GarryBGoode/VibeSupply/out/placement_control.png

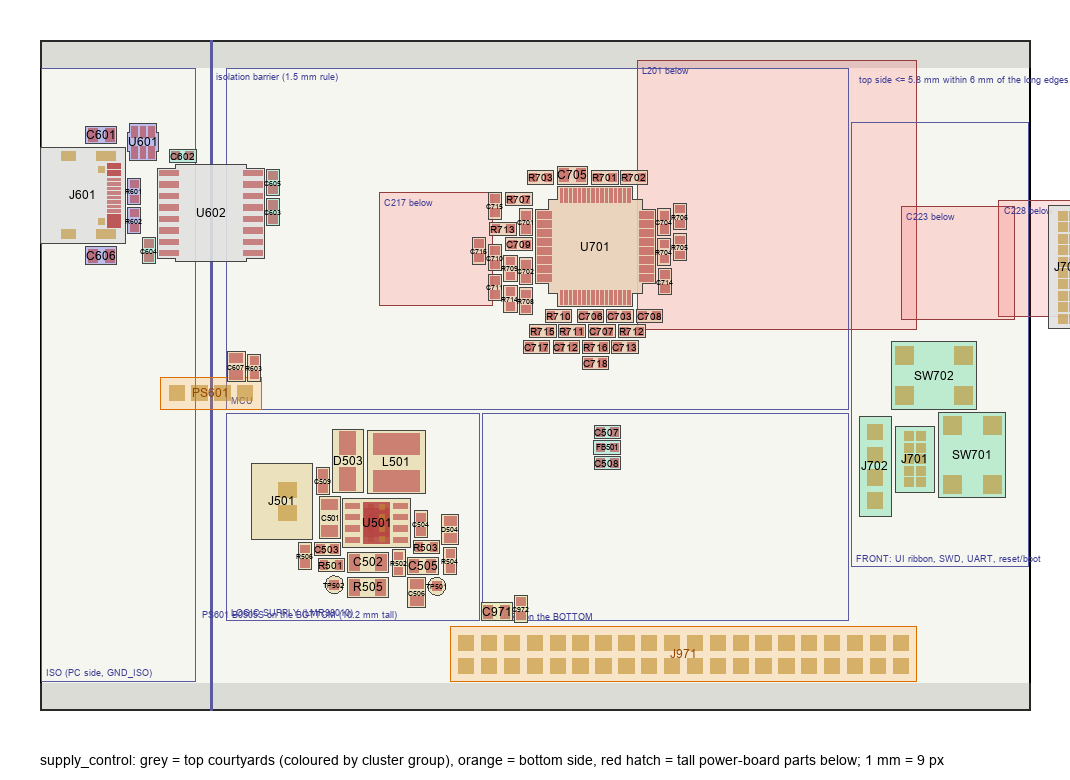
out/placement_control.png
