GarryBGoode/VibeSupply/out/placement_power.png

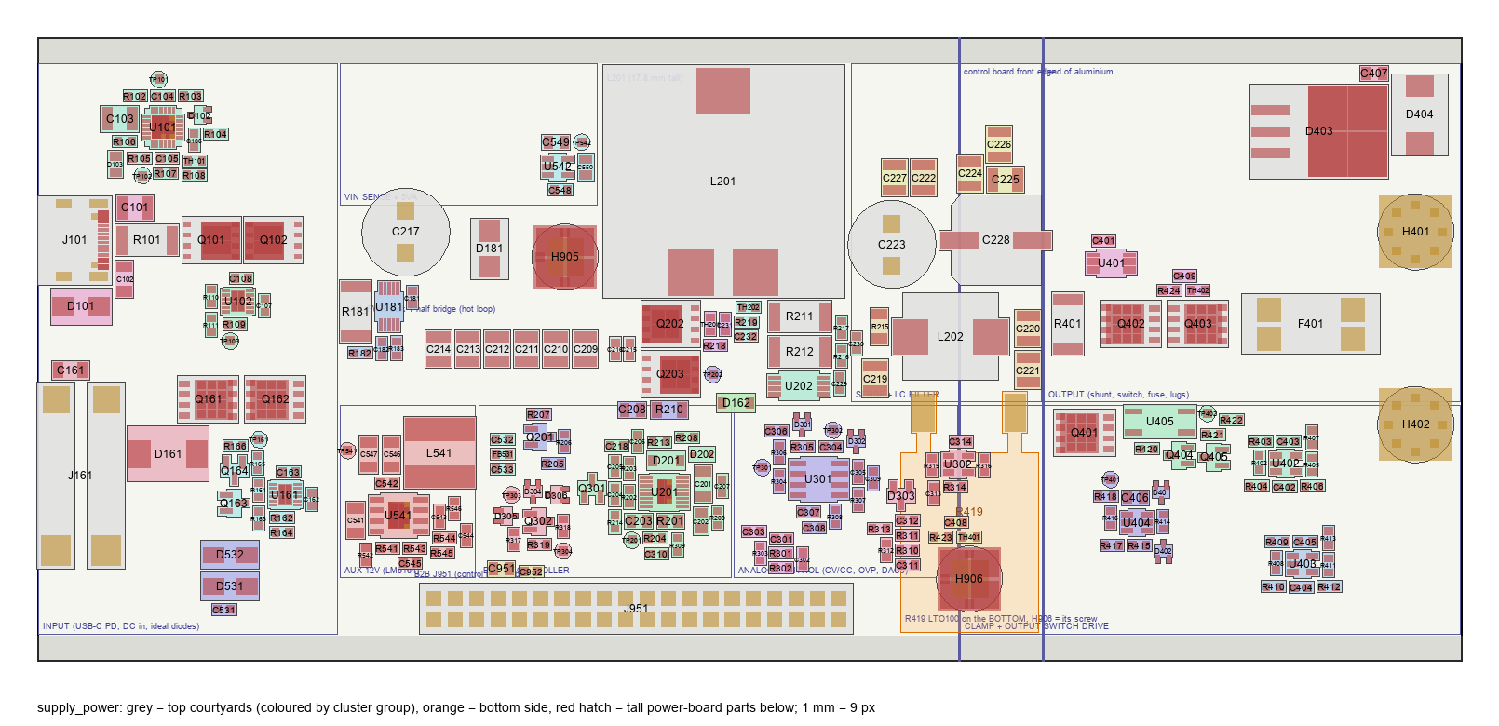
out/placement_power.png
