GarryBGoode/VibeSupply/out/placement_ui.png

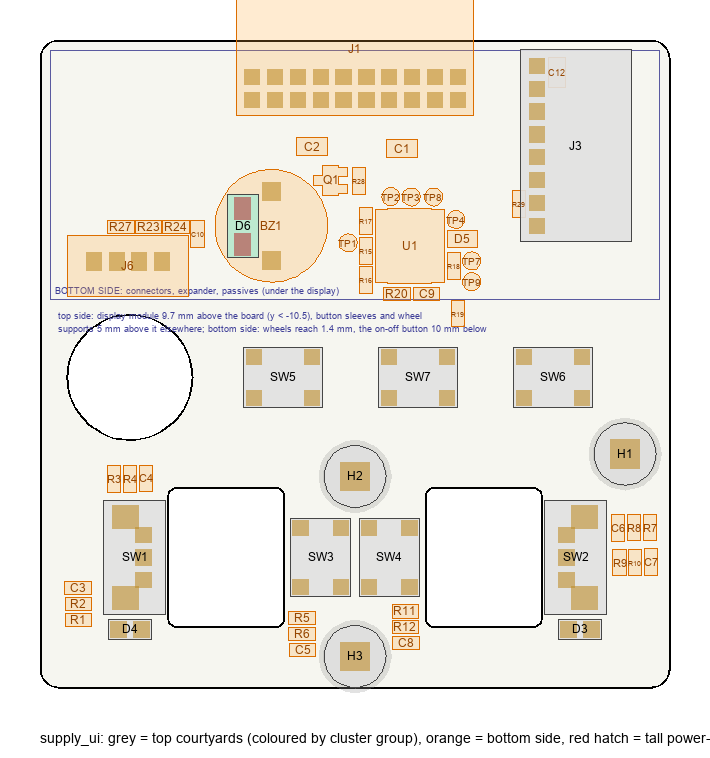
out/placement_ui.png
