GarryBGoode/VibeSupply/sim/plots/t0_ith_probe.png

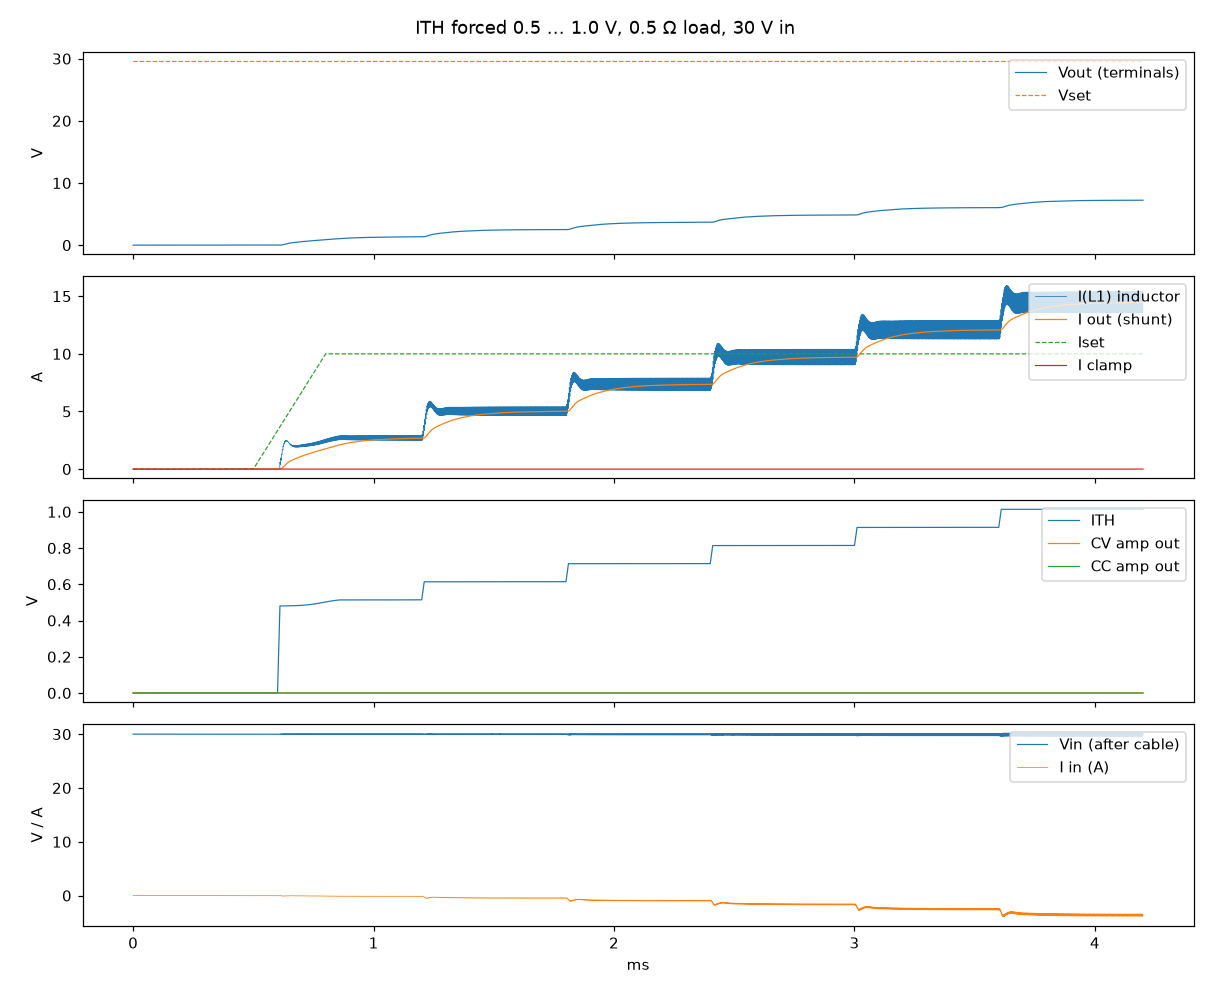
sim/plots/t0_ith_probe.png
