GarryBGoode/VibeSupply/sim/plots/t2_cv_pwm.png

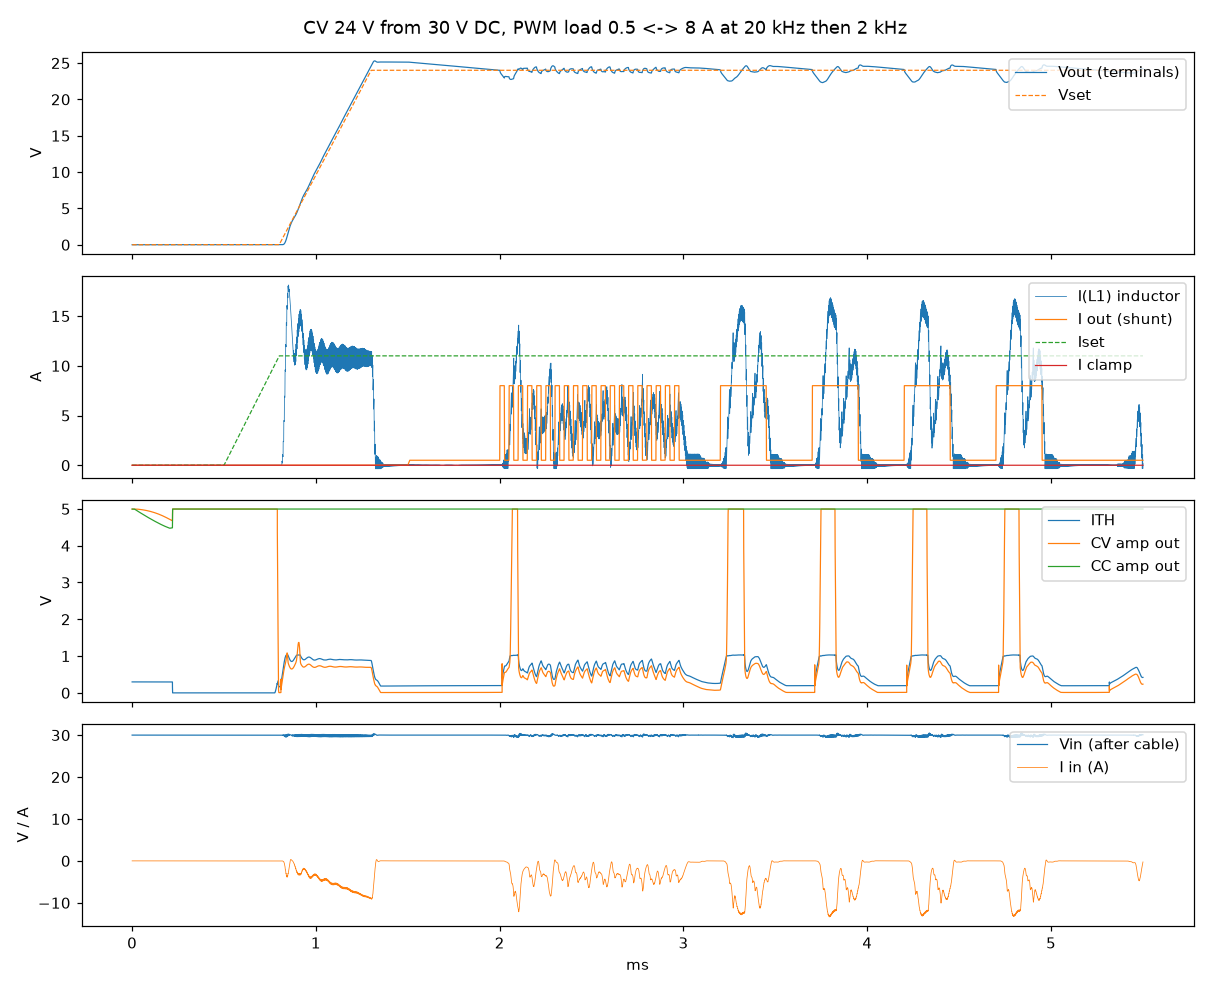
sim/plots/t2_cv_pwm.png
