GarryBGoode/VibeSupply/sim/plots/t3_cc_short.png

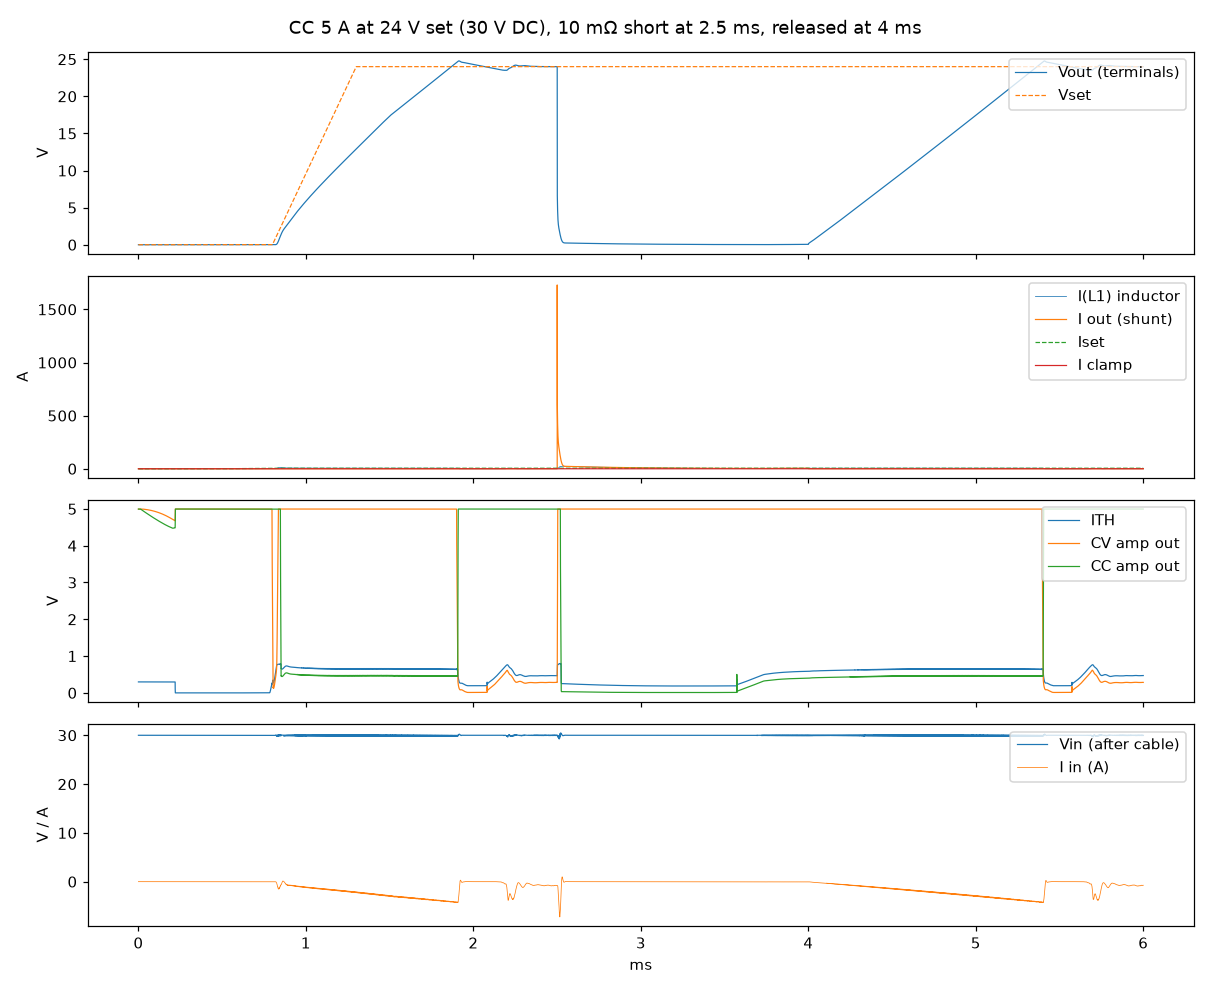
sim/plots/t3_cc_short.png
