GarryBGoode/VibeSupply/sim/plots/t4_regen.png

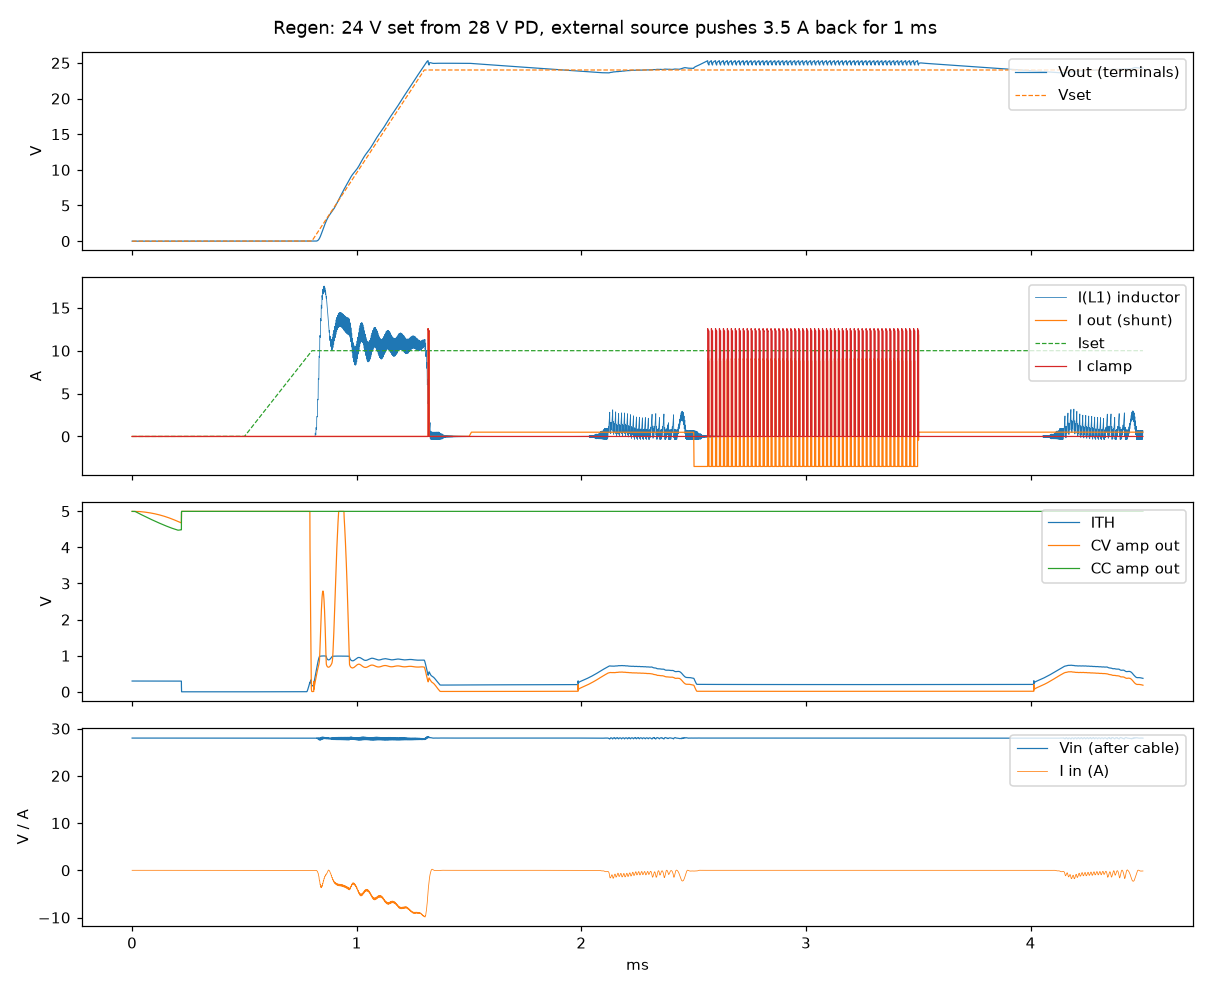
sim/plots/t4_regen.png
