GarryBGoode/VibeSupply/sim/plots/t5_26v5_10a.png

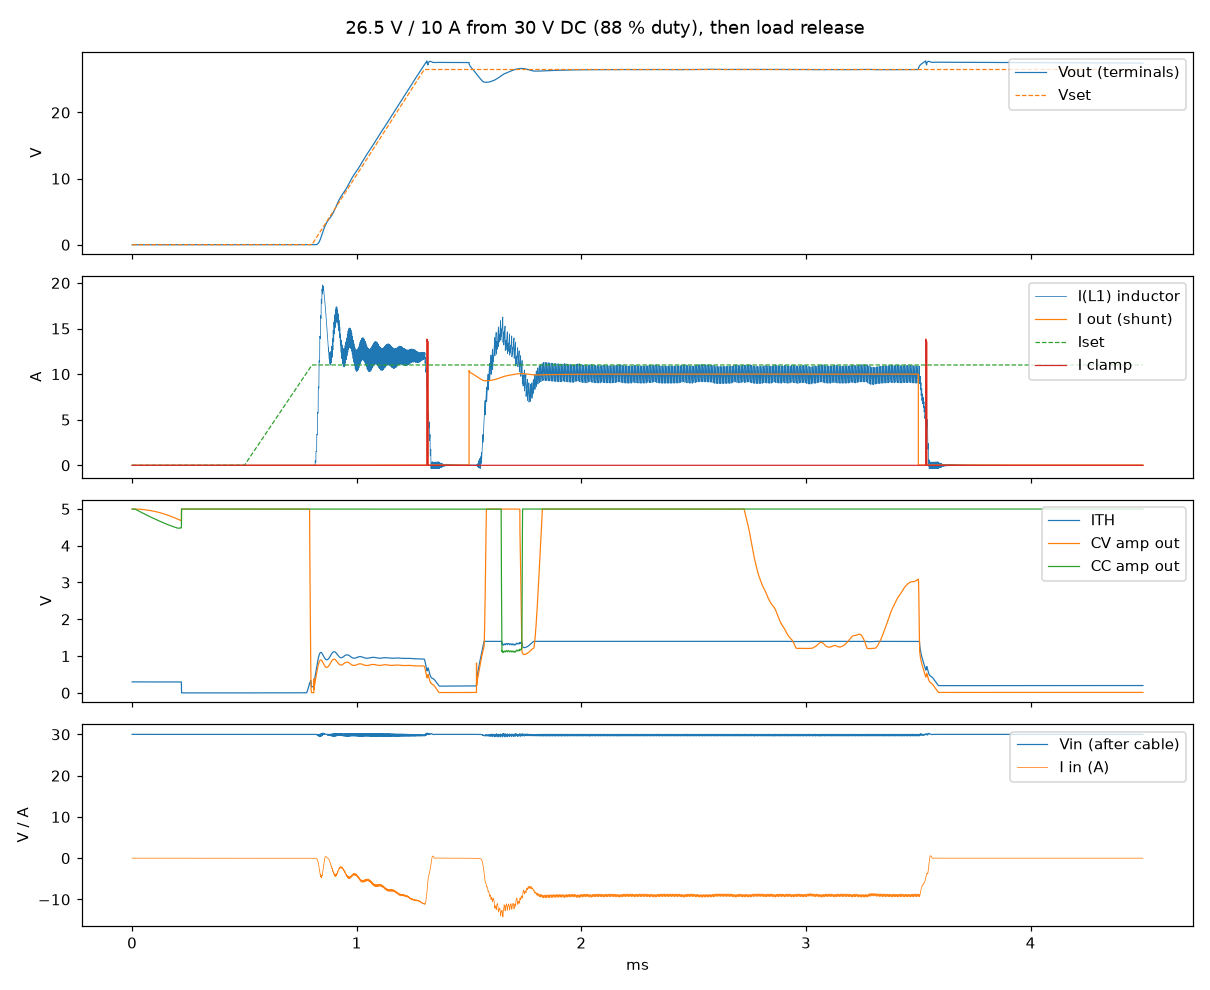
sim/plots/t5_26v5_10a.png
