GarryBGoode/VibeSupply/sim/plots/t6_1v_10a.png

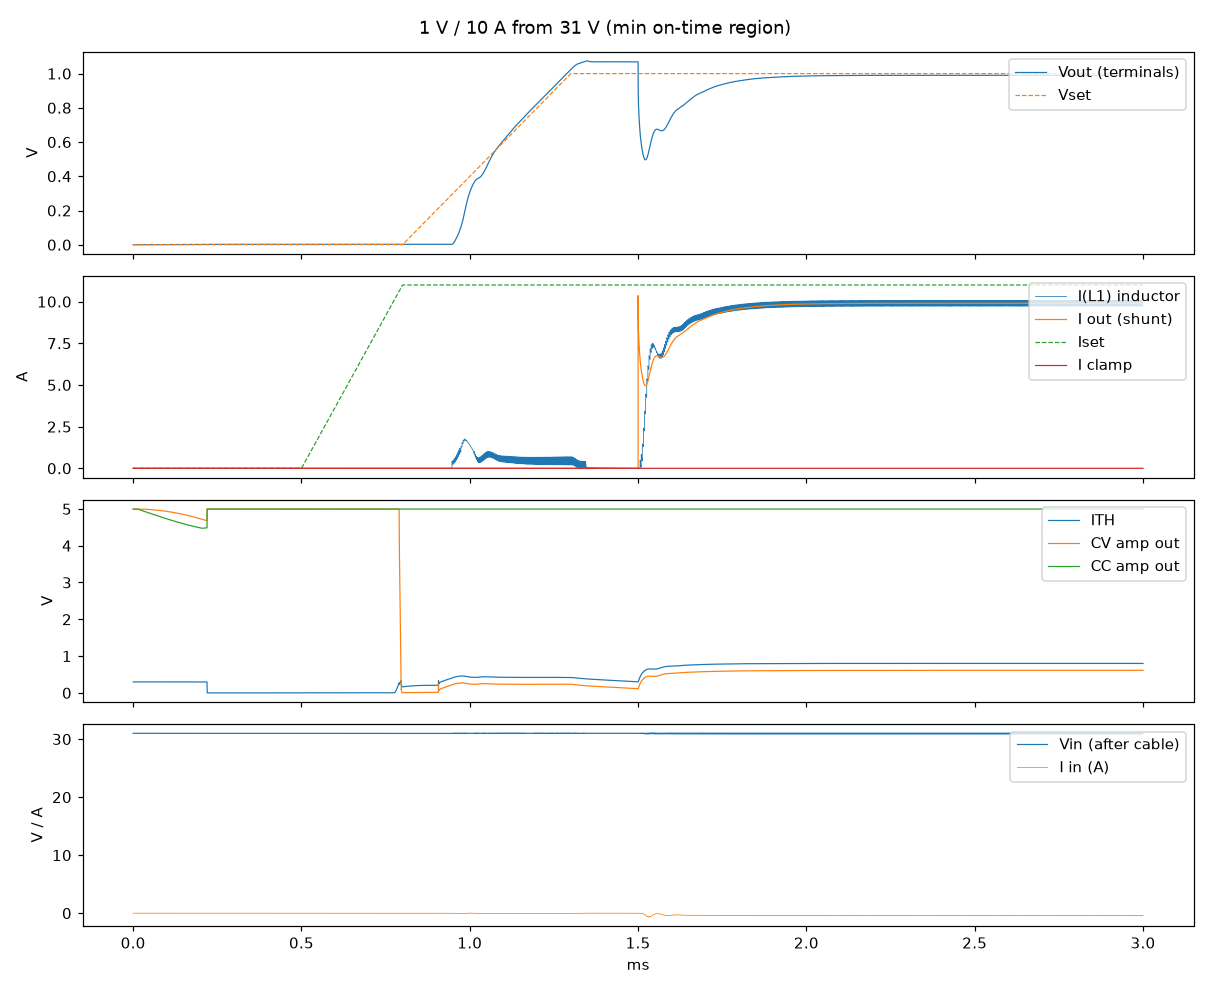
sim/plots/t6_1v_10a.png
