GarryBGoode/VibeSupply/sim/plots/t7_dropout.png

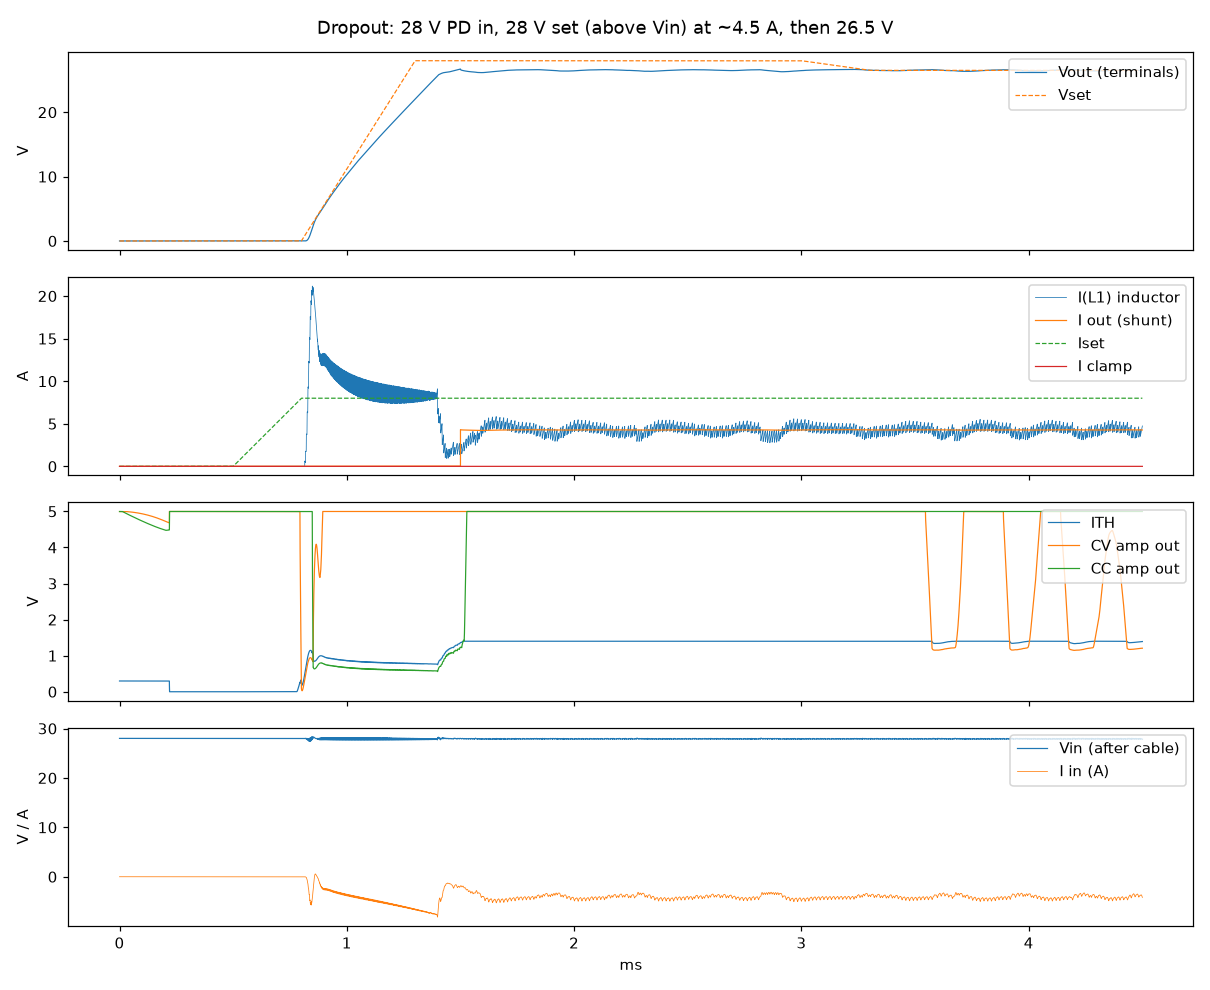
sim/plots/t7_dropout.png
