GarryBGoode/VibeSupply/sim/plots/t8_long_idle.png

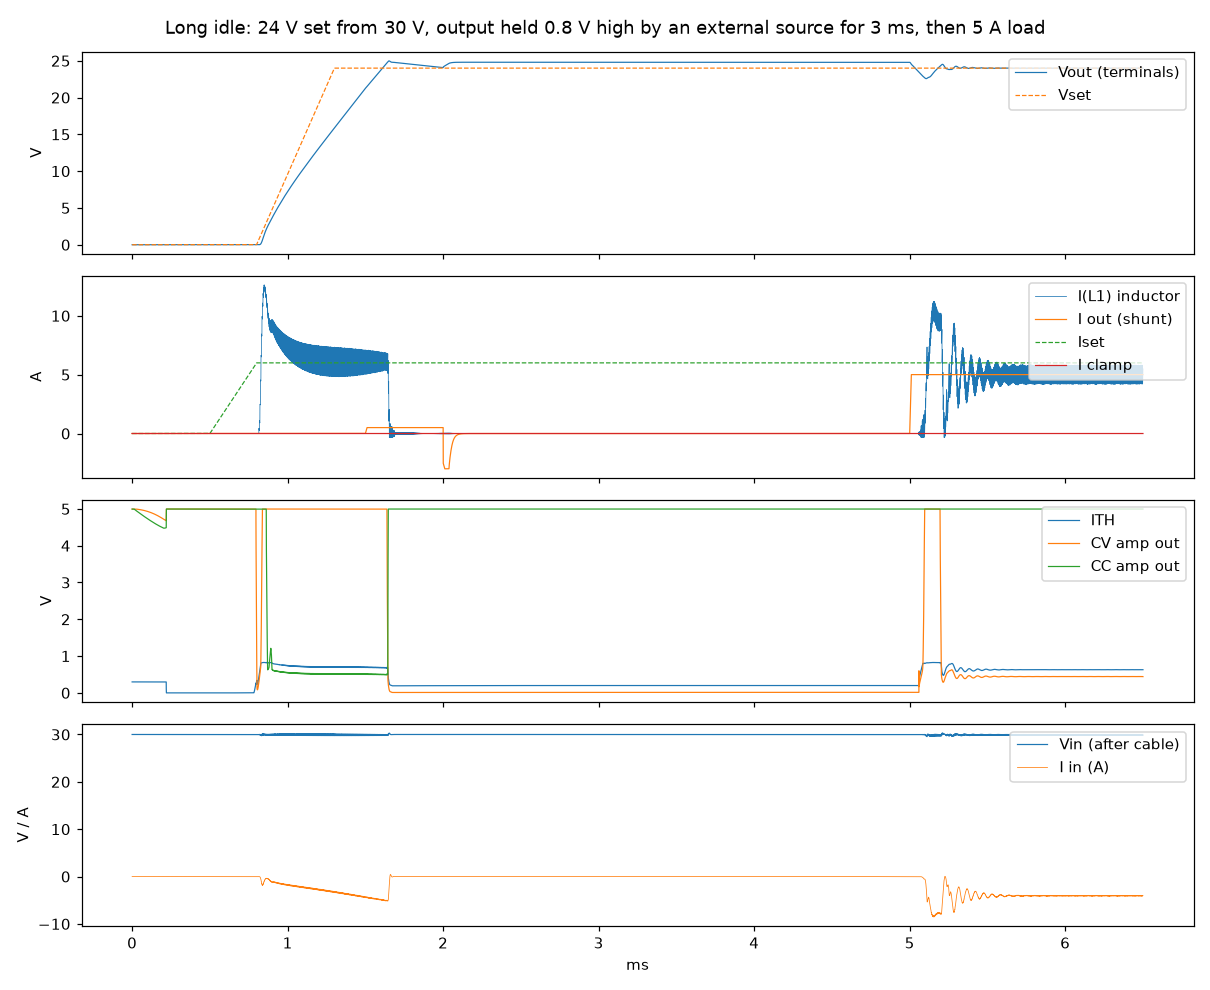
sim/plots/t8_long_idle.png
