GarryBGoode/VibeSupply/sim/plots/t050_ith_map.png

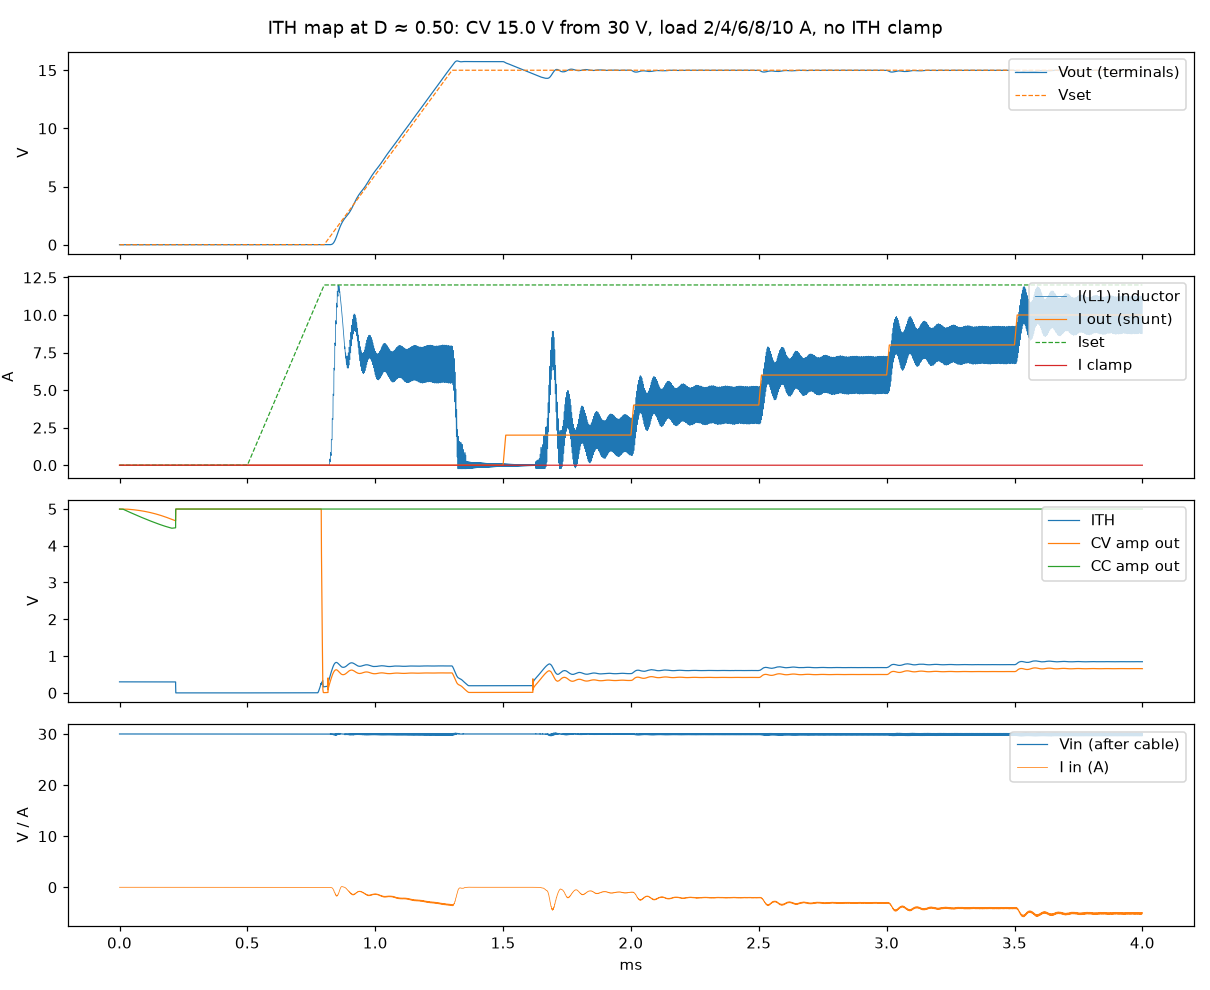
sim/plots/t050_ith_map.png
