GarryBGoode/VibeSupply/sim/plots/t075_ith_map.png

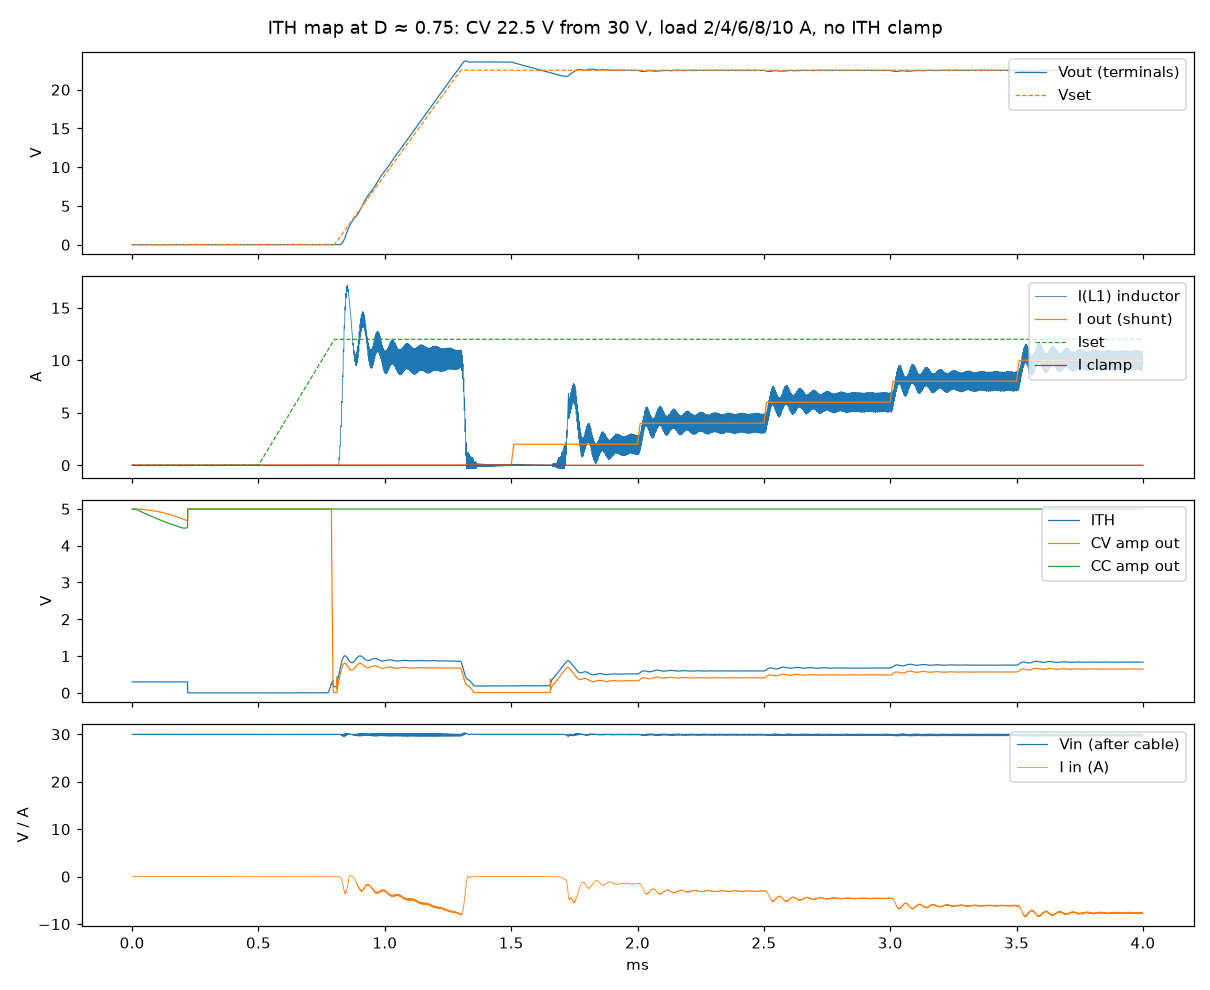
sim/plots/t075_ith_map.png
