GarryBGoode/VibeSupply/sim/plots/t088_ith_map.png

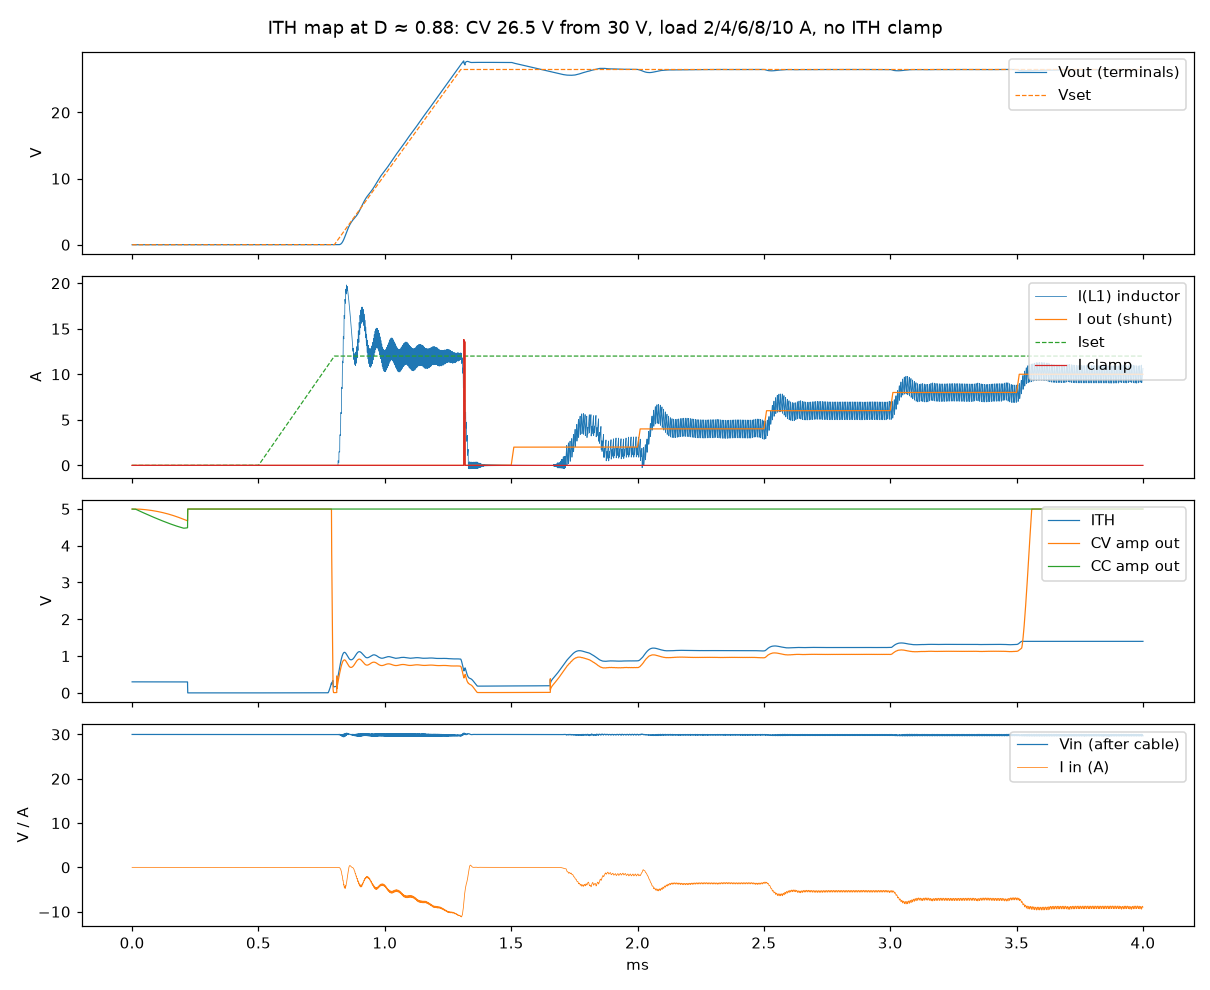
sim/plots/t088_ith_map.png
