GarryBGoode/VibeSupply/sim/plots/zoom_highduty.png

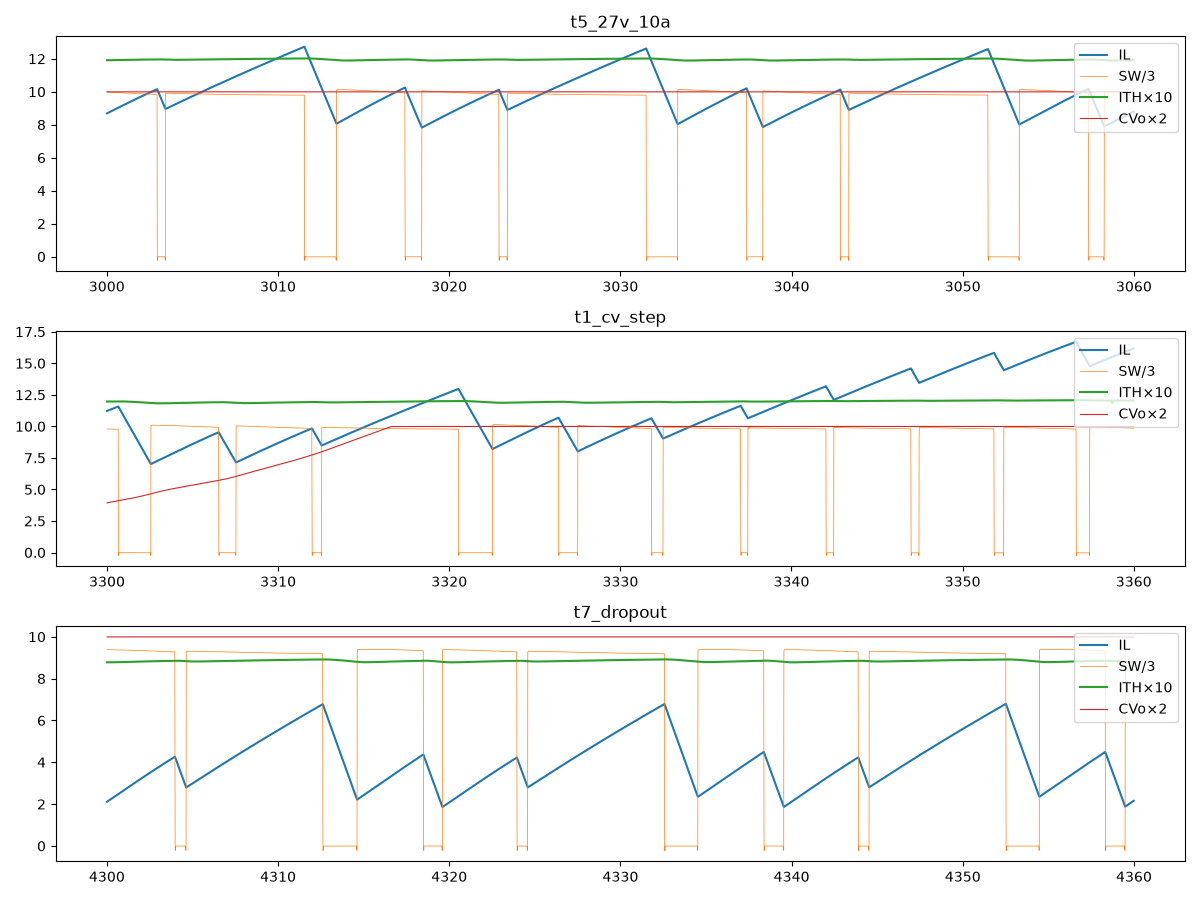
sim/plots/zoom_highduty.png
