GarryBGoode/VibeSupply/sim/plots/zoom_t2_glitch_gates.png

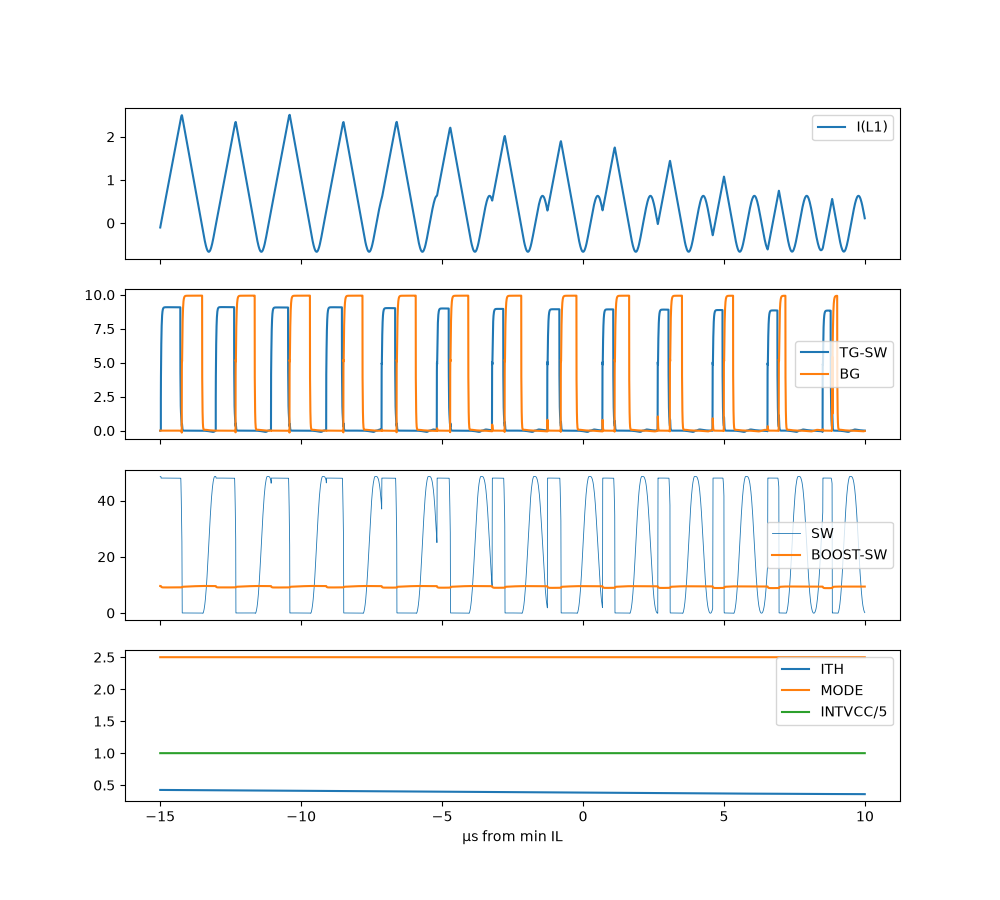
sim/plots/zoom_t2_glitch_gates.png
