GarryBGoode/VibeSupply/out/supply_power_bom.csv

Qty | Refs | Part | Value | Footprint | LCSC | DNP
16 | C101 C103 C209 C210 C211 C212 C213 C214 C219 C220 C221 C222 C224 C225 C226 C227 | C | 4.7u | Capacitor_SMD:C_1210_3225Metric | C913445
3 | C102 C161 C201 | C | 1u | Capacitor_SMD:C_1206_3216Metric
3 | C104 C305 C532 | C | 1u | Capacitor_SMD:C_0603_1608Metric
28 | C105 C106 C107 C108 C162 C163 C181 C182 C207 C215 C216 C229 C231 C232 C301 C302 C304 C313 C314 C401 C403 C405 C408 C409 C531 C533 C542 C952 | C | 100n | Capacitor_SMD:C_0603_1608Metric
3 | C202 C406 C549 | C | 1u | Capacitor_SMD:C_0805_2012Metric
2 | C203 C951 | C | 4.7u | Capacitor_SMD:C_0805_2012Metric
7 | C204 C218 C230 C310 C402 C404 C545 | C | 1n | Capacitor_SMD:C_0603_1608Metric
1 | C205 | C | 100p | Capacitor_SMD:C_0603_1608Metric
5 | C206 C303 C311 C312 C548 | C | 10n | Capacitor_SMD:C_0603_1608Metric
1 | C208 | C | 1n | Capacitor_SMD:C_0805_2012Metric
1 | C217 | C_Polarized | 100u 100V | Capacitor_THT:CP_Radial_D10.0mm_P5.00mm | C443138
1 | C223 | C_Polarized | 100u 63V | Capacitor_THT:CP_Radial_D10.0mm_P5.00mm | C2691842
1 | C228 | C_Polarized | 100u 63V | Capacitor_SMD:CP_Elec_10x12.6 | C5154285
2 | C306 C309 | C | 1.3n | Capacitor_SMD:C_0603_1608Metric
1 | C307 | C | 68p | Capacitor_SMD:C_0603_1608Metric
1 | C308 | C | 27n | Capacitor_SMD:C_0603_1608Metric
1 | C407 | C | 100n | Capacitor_SMD:C_0805_2012Metric
1 | C541 | C | 2.2u | Capacitor_SMD:C_1206_3216Metric
1 | C543 | C | 2.2n | Capacitor_SMD:C_0603_1608Metric
1 | C544 | C | 3.3n | Capacitor_SMD:C_0603_1608Metric
2 | C546 C547 | C | 10u | Capacitor_SMD:C_1206_3216Metric
1 | C550 | C | 2.2u | Capacitor_SMD:C_0805_2012Metric
1 | D101 | D_Zener | SMBJ30A | Diode_SMD:D_SMB | C113998
8 | D102 D301 D302 D304 D305 D306 D401 D402 | BAT54W | BAT54W | Package_TO_SOT_SMD:SOT-323_SC-70
1 | D103 | LED | green | LED_SMD:LED_0805_2012Metric
2 | D161 D404 | D_Zener | SMCJ54A | Diode_SMD:D_SMC | C438116
1 | D162 | D_Zener | BZT52C12 | Diode_SMD:D_SOD-123
1 | D181 | D_Zener | SMBJ33A | Diode_SMD:D_SMB | C173526
1 | D201 | D_Zener | BZT52C36 | Diode_SMD:D_SOD-123 | C19077420
1 | D202 | D_Schottky | CMDSH-4E | Diode_SMD:D_SOD-323 | C5240486
1 | D303 | BAT54S | BAT54S | Package_TO_SOT_SMD:SOT-23
1 | D403 | D_Schottky_Dual_CommonCathode_AKA | MBRB40100CT | Package_TO_SOT_SMD:TO-263-3_TabPin2
2 | D531 D532 | D_Schottky | SS110 | Diode_SMD:D_SMA
1 | F401 | Fuse | 15A 32V MINI | Fuse:Fuseholder_Blade_Mini_Keystone_3568
1 | FB531 | FerriteBead_Small | 600R@100MHz | Inductor_SMD:L_0603_1608Metric
1 | H401 | MountingHole_Pad | POST+ | MountingHole:MountingHole_4.3mm_M4_Pad_Via
1 | H402 | MountingHole_Pad | POST- | MountingHole:MountingHole_4.3mm_M4_Pad_Via
1 | H905 | MountingHole_Pad | GND screw (M3 insert) | Mounting_Wuerth:Mounting_Wuerth_WA-SMSI-M3_H3mm_9774030360
1 | H906 | MountingHole_Pad | LTO100 screw (M3 insert) | Mounting_Wuerth:Mounting_Wuerth_WA-SMSI-M3_H3mm_9774030360
1 | J101 | USB_C_Receptacle_USB2.0_16P | USB_C_Receptacle_USB2.0_16P | Connector_USB:USB_C_Receptacle_GCT_USB4105-xx-A_16P_TopMnt_Horizontal | C3020560
1 | J161 | Conn_01x02 | DC IN wires | Connector_Wire:SolderWire-1.5sqmm_1x02_P6mm_D1.7mm_OD3mm_Relief
1 | J951 | Conn_02x20_Odd_Even | B2B to supply_control | Connector_PinSocket_2.54mm:PinSocket_2x20_P2.54mm_Vertical
1 | L201 | L | 10uH SER2918H-103KL | supply1:L_Coilcraft_SER2918H | C3911665
1 | L202 | L | 0.47uH | Inductor_SMD:L_Changjiang_FXL1040 | C475921
1 | L541 | L | 68uH | Inductor_SMD:L_Bourns-SRN8040_8x8.15mm
2 | Q101 Q102 | CSD18532Q5B | CSD18540Q5B | Package_TO_SOT_SMD:TDSON-8-1 | C86513
2 | Q161 Q162 | BSC040N10NS5 | ISC030N10NM6 | Package_SON:Infineon_PG-TDSON-8_6.15x5.15mm | C3278643
6 | Q163 Q164 Q201 Q302 Q404 Q405 | 2N7002 | 2N7002 | Package_TO_SOT_SMD:SOT-23
2 | Q202 Q203 | CSD18531Q5A | CSD18531Q5A | Package_TO_SOT_SMD:TDSON-8-1 | C2876524
1 | Q301 | BC857 | BC857 | Package_TO_SOT_SMD:SOT-23 | C556165
3 | Q401 Q402 Q403 | BSC040N10NS5 | BSC040N10NS5 | Package_SON:Infineon_PG-TDSON-8_6.15x5.15mm | C534334
1 | R101 | R | 5m | Resistor_SMD:R_2512_6332Metric | C2903482
1 | R102 | R | 200 | Resistor_SMD:R_0603_1608Metric
2 | R103 R104 | R | 5.1k | Resistor_SMD:R_0603_1608Metric
15 | R105 R108 R109 R163 R166 R207 R309 R317 R319 R414 R415 R418 R422 R541 R543 | R | 100k | Resistor_SMD:R_0603_1608Metric
6 | R106 R107 R205 R206 R301 R302 | R | 1k | Resistor_SMD:R_0603_1608Metric
2 | R110 R161 | R | 243k | Resistor_SMD:R_0603_1608Metric
22 | R111 R162 R183 R203 R217 R218 R219 R305 R307 R311 R313 R314 R316 R318 R403 R404 R409 R410 R421 R423 R424 R545 | R | 10k | Resistor_SMD:R_0603_1608Metric
1 | R164 | R | 15k | Resistor_SMD:R_0603_1608Metric
3 | R165 R407 R413 | R | 1M | Resistor_SMD:R_0603_1608Metric
2 | R181 R401 | R | 1m | Resistor_SMD:R_2512_6332Metric | C2903470
2 | R182 R408 | R | 120k | Resistor_SMD:R_0603_1608Metric
1 | R201 | R | 10 | Resistor_SMD:R_0805_2012Metric
1 | R202 | R | 61.9k | Resistor_SMD:R_0603_1608Metric
1 | R204 | R | 124k | Resistor_SMD:R_0603_1608Metric
1 | R208 | R | 1 | Resistor_SMD:R_0603_1608Metric
1 | R209 | R | 0 | Resistor_SMD:R_0603_1608Metric
1 | R210 | R | 2.2 | Resistor_SMD:R_1206_3216Metric
2 | R211 R212 | R | 4m | Resistor_SMD:R_2512_6332Metric | C2904236
2 | R213 R214 | R | 10 | Resistor_SMD:R_0603_1608Metric
1 | R215 | R | 0.1 | Resistor_SMD:R_1206_3216Metric
3 | R216 R406 R412 | R | 4.7k | Resistor_SMD:R_0603_1608Metric
1 | R303 | R | 100 | Resistor_SMD:R_0603_1608Metric
2 | R304 R402 | R | 91.9k | Resistor_SMD:R_0603_1608Metric
1 | R306 | R | 47.5k | Resistor_SMD:R_0603_1608Metric
1 | R308 | R | 2.4k | Resistor_SMD:R_0603_1608Metric
2 | R310 R312 | R | 110k | Resistor_SMD:R_0603_1608Metric
1 | R315 | R | 11.5k | Resistor_SMD:R_0603_1608Metric
2 | R405 R546 | R | 470k | Resistor_SMD:R_0603_1608Metric
1 | R411 | R | 10.2k | Resistor_SMD:R_0603_1608Metric
1 | R416 | R | 4.7 | Resistor_SMD:R_0603_1608Metric
1 | R417 | R | 2.2 | Resistor_SMD:R_0603_1608Metric
1 | R419 | R | 2R 100W LTO100 | Package_TO_SOT_THT:TO-247-2_Horizontal_TabDown | C3546229
1 | R420 | R | 91 | Resistor_SMD:R_0603_1608Metric
1 | R542 | R | 22k | Resistor_SMD:R_0603_1608Metric
1 | R544 | R | 90.9k | Resistor_SMD:R_0603_1608Metric
5 | TH101 TH201 TH202 TH401 TH402 | Thermistor_NTC | 10k B3950 | Resistor_SMD:R_0603_1608Metric
14 | TP101 TP102 TP103 TP161 TP201 TP202 TP301 TP302 TP303 TP304 TP401 TP402 TP541 TP542 | TestPoint | TestPoint | TestPoint:TestPoint_Pad_D1.0mm
1 | U101 | AP33772S | AP33772S | Package_DFN_QFN:QFN-24-1EP_4x4mm_P0.5mm_EP2.7x2.7mm_ThermalVias | C50341643
2 | U102 U161 | LM74800 | LM74800 | Package_SON:WSON-12-1EP_3x3mm_P0.5mm_EP1.5x2.5mm | C3215600
2 | U181 U401 | INA228 | INA228 | Package_SO:TSSOP-10_3x3mm_P0.5mm | C2887910
1 | U201 | LTC7803 | LTC7803 | Package_SO:MSOP-16-1EP_3x4.039mm_P0.5mm_EP1.651x2.845mm_ThermalVias | C1016554
1 | U202 | INA240A3PW | INA240A3PW | Package_SO:TSSOP-8_4.4x3mm_P0.65mm | C544538
1 | U301 | ADA4522-2 | ADA4522-2 | Package_SO:SOIC-8_3.9x4.9mm_P1.27mm | C403697
3 | U302 U402 U403 | LMV331 | LMV331 | Package_TO_SOT_SMD:SOT-23-5
1 | U404 | UCC27511ADBV | UCC27511ADBV | Package_TO_SOT_SMD:SOT-23-6
1 | U405 | VOM1271 | VOM1271 | Package_SO:SO-4_4.4x3.6mm_P2.54mm | C146286
1 | U541 | LM5164DDA | LM5164DDA | Package_SO:HSOP-8-1EP_3.9x4.9mm_P1.27mm_EP2.41x3.1mm_ThermalVias | C477928
1 | U542 | LP2985-5.0 | LP2985-5.0 | Package_TO_SOT_SMD:SOT-23-5 | C74511
