GarryBGoode/VibeSupply/sim/plots/t1_cv_step.png

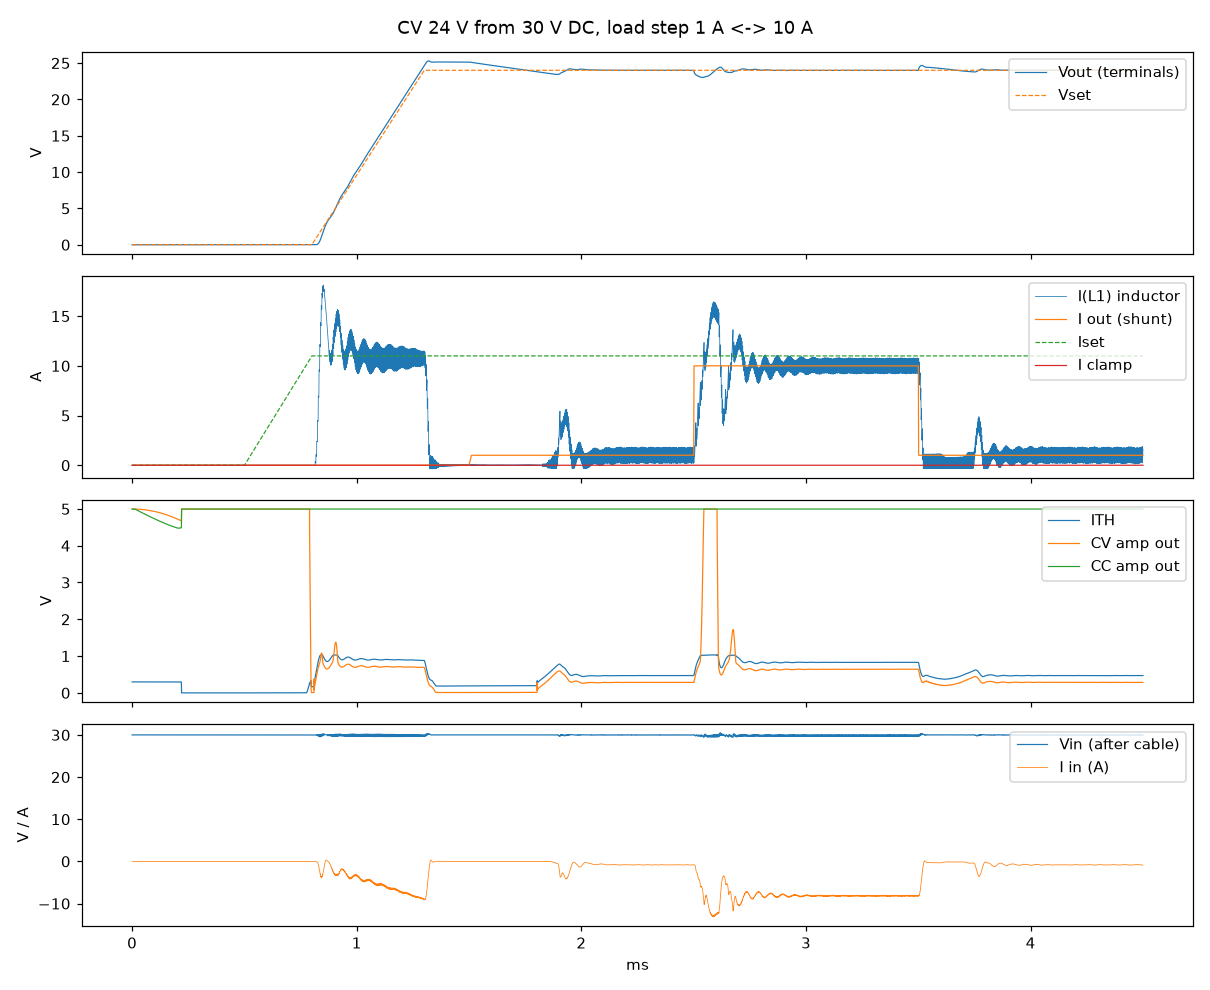
sim/plots/t1_cv_step.png
