GarryBGoode/VibeSupply/sim/t0.cir

* batch test
V1 in 0 PULSE(0 1 0 1u 1u 1m 2m)
R1 in out 1k
C1 out 0 1u
.tran 5m
.end
