GarryBGoode/VibeSupply/(list of files, drawings)

Other design files:
kicad/supply_ui/supply_ui/supply_ui_dsn.dsn
