GarryBGoode/VibeSupply/kicad/supply_ui/supply_ui/supply_ui.kicad_pcb

## KiCad design kicad/supply_ui/supply_ui/supply_ui.kicad_pcb (2026-10-05)

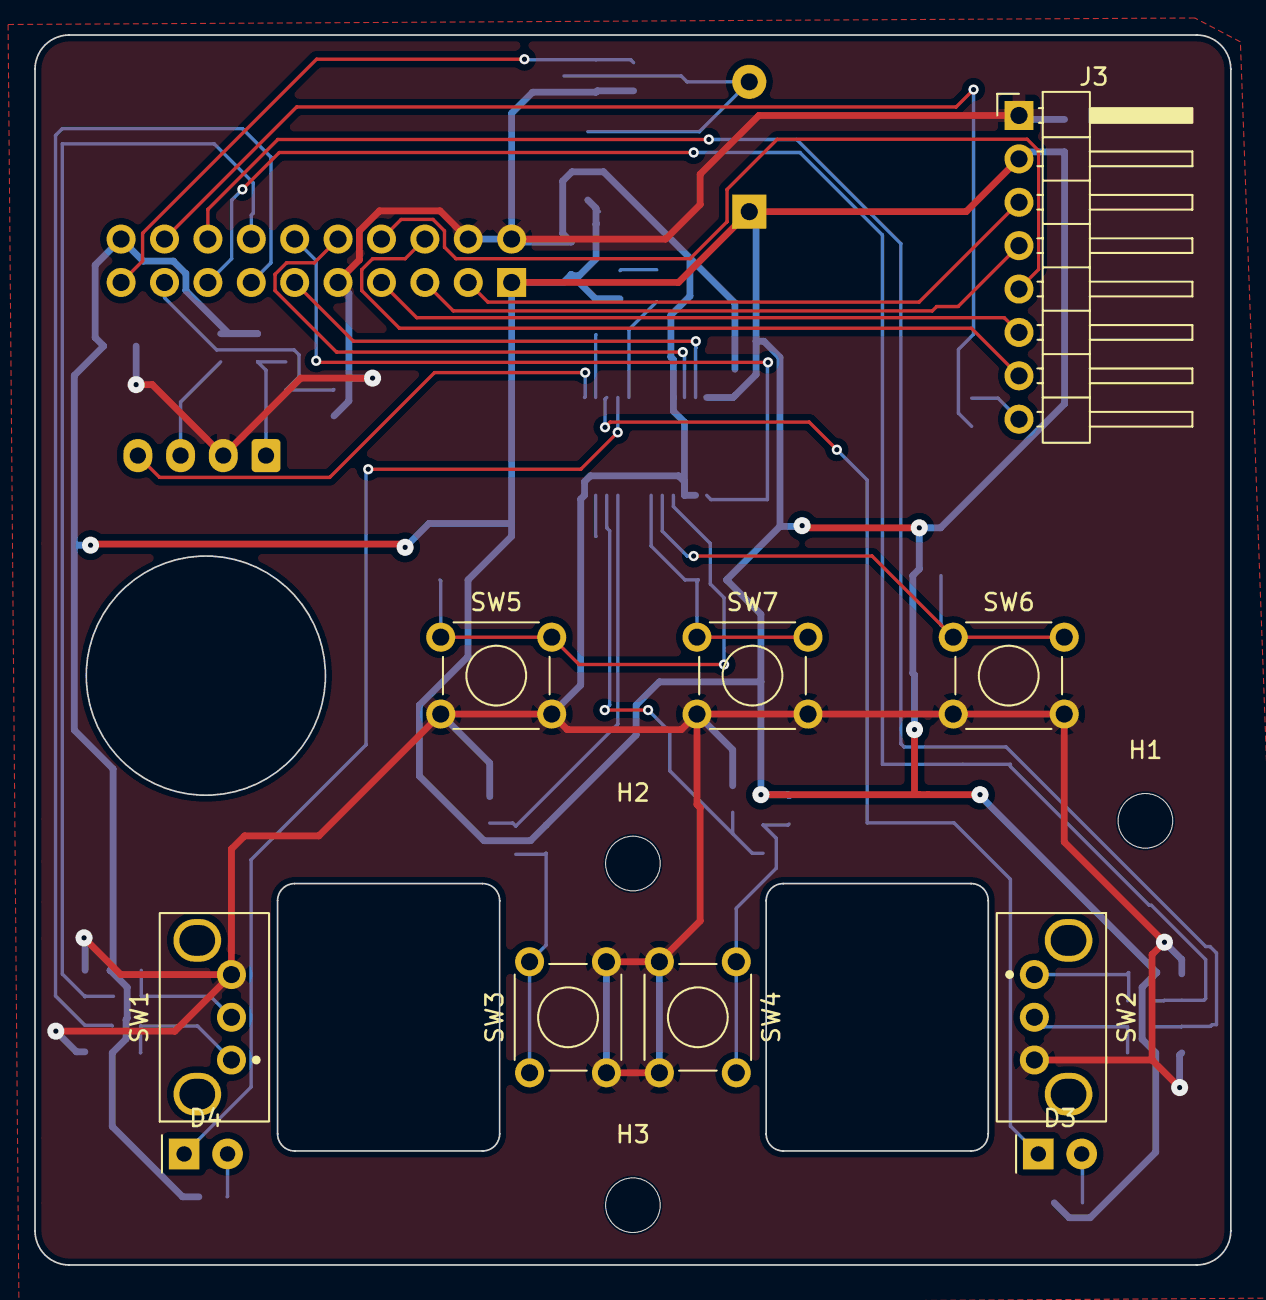
[picture p18: board supply_ui.kicad_pcb from above]

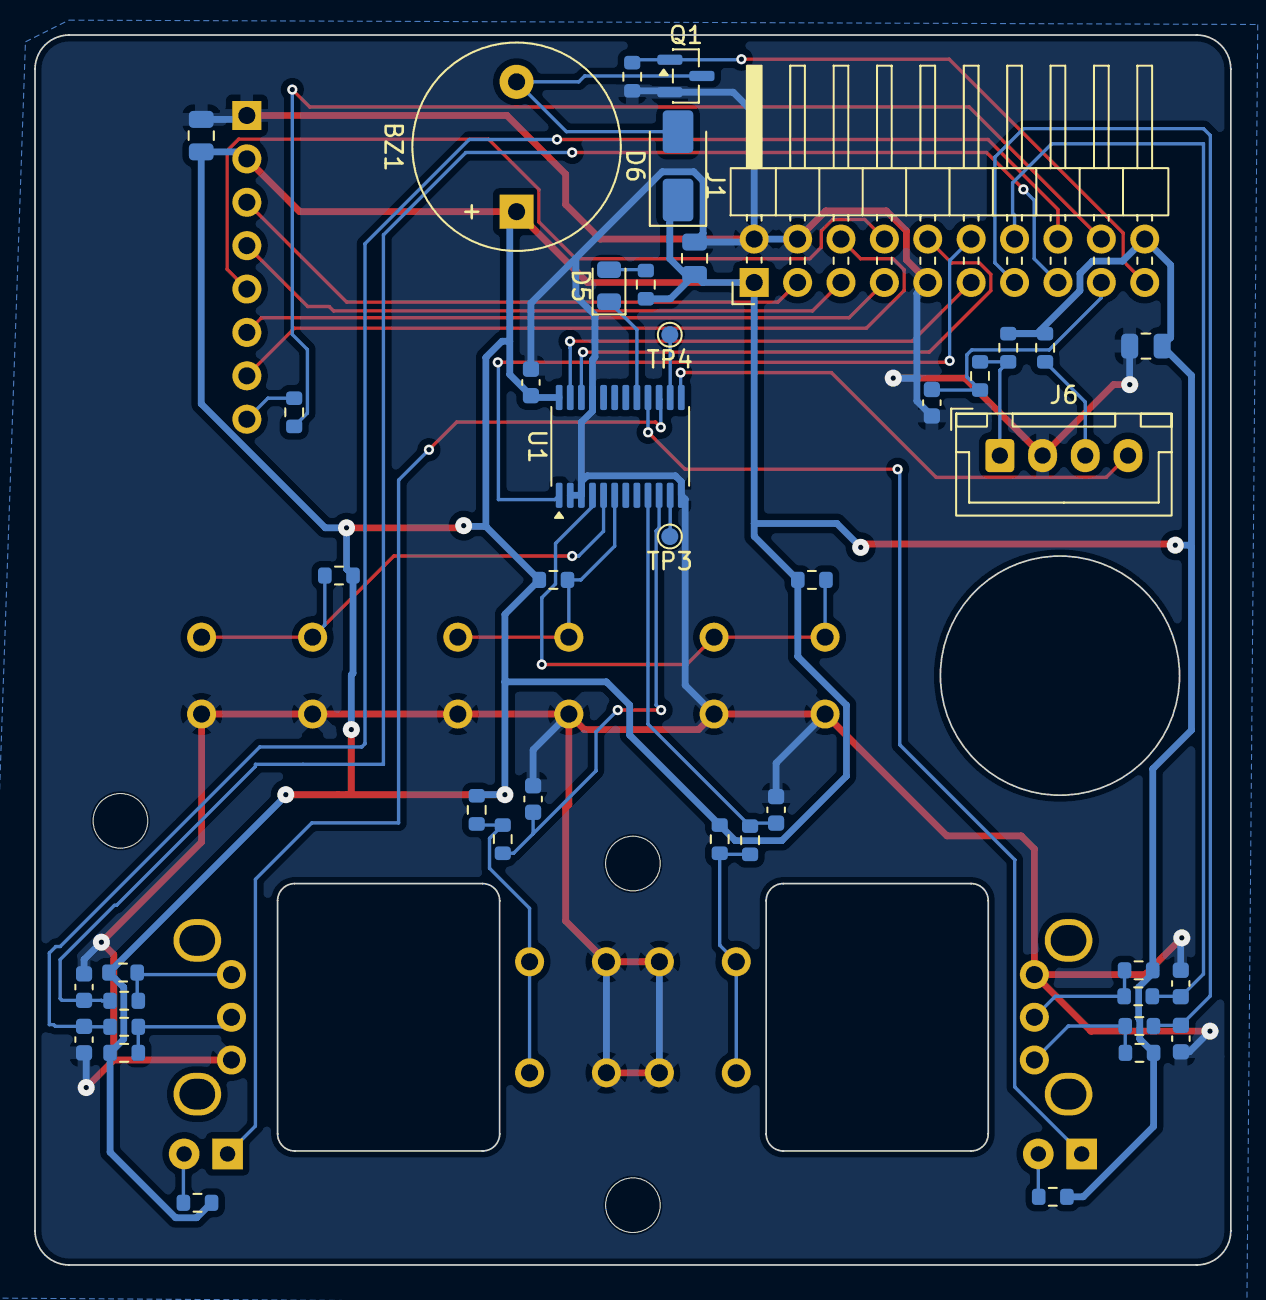
[picture p19: board supply_ui.kicad_pcb from below]

Board: 2 copper layers, 70.0 x 72.0 mm, 56 parts (43 on the bottom side), 41 nets.

Parts:
BZ1: magnetic 3V; Buzzer_12x9.5RM7.6
C1, C12: 10u; C_0805_2012Metric
C2: 100n; C_0805_2012Metric
C3, C4, C5, C6, C7, C8, C10: 10n; C_0603_1608Metric
C9: 100n; C_0603_1608Metric
D3: red 3mm diffused CC; LED_D3.0mm_Standoff
D4: green 3mm diffused CV; LED_D3.0mm_Standoff
D5: yellow; LED_0805_2012Metric
D6: SS14; D_SMA
H1, H2, H3: M3; MountingHole_3.2mm_M3
J1: to supply_control; PinHeader_2x10_P2.54mm_Horizontal
J3: IPS 1.9in ST7789 SPI (wired); PinHeader_1x08_P2.54mm_Horizontal
J6: OUTPUT panel button; JST_XH_B4B-XH-A_1x04_P2.50mm_Vertical
Q1: 2N7002; SOT-23
R1, R3, R5, R7, R9, R11, R15, R16, R17, R23: 10k; R_0603_1608Metric
R2, R4, R6, R8, R10, R12, R24: 1k; R_0603_1608Metric
R18, R19, R20: 330; R_0603_1608Metric
R27, R29: 100; R_0603_1608Metric
R28: 100k; R_0603_1608Metric
SW1, SW2: EC10E1220505; RotaryEncoder_Alps_EC10E_Horizontal
SW3: V WHEEL PUSH; SW_TH_Tactile_Omron_B3F-102x
SW4: I WHEEL PUSH; SW_TH_Tactile_Omron_B3F-102x
SW5: LEFT; SW_TH_Tactile_Omron_B3F-102x
SW6: RIGHT; SW_TH_Tactile_Omron_B3F-102x
SW7: ENTER; SW_TH_Tactile_Omron_B3F-102x
TP3, TP4: TestPoint; TestPoint_Pad_D1.0mm
U1: TCA9535PWR; TSSOP-24_4.4x7.8mm_P0.65mm

Connections:
+3V3: BZ1.1, C1.1, C2.1, C9.1, C12.1, D6.1, J1.1, J1.20, J3.2, R1.1, R3.1, R5.1, R7.1, R9.1, R11.1, R15.1, R16.1, R17.1, R18.1, R19.1, R20.1, R23.1, R27.1, U1.24
BTN_ENTER: R17.2, SW7.1, U1.6
BTN_LEFT: R15.2, SW5.1, U1.4
BTN_RIGHT: R16.2, SW6.1, U1.5
BUZZER: J1.19, Q1.1, R28.1
BUZZER_K: BZ1.2, D6.2, Q1.3
ENC1_A: C3.1, J1.13, R2.2
ENC1_A_RAW: R1.2, R2.1, SW1.A
ENC1_B: C4.1, J1.14, R4.2
ENC1_B_RAW: R3.2, R4.1, SW1.B
ENC1_SW: C5.1, R6.2, U1.9
ENC1_SW_RAW: R5.2, R6.1, SW3.1
ENC2_A: C6.1, J1.15, R8.2
ENC2_A_RAW: R7.2, R8.1, SW2.A
ENC2_B: C7.1, J1.16, R10.2
ENC2_B_RAW: R9.2, R10.1, SW2.B
ENC2_SW: C8.1, R12.2, U1.10
ENC2_SW_RAW: R11.2, R12.1, SW4.1
GND: C1.2, C2.2, C3.2, C4.2, C5.2, C6.2, C7.2, C8.2, C9.2, C10.2, C12.2, J1.2, J1.4, J1.9, J3.1, J6.2, Q1.2, R28.2, SW1.C, SW2.C, SW3.2, SW4.2, SW5.2, SW6.2, SW7.2, U1.2, U1.3, U1.12, U1.21
I2C2_SCL: J1.10, U1.22
I2C2_SDA: J1.11, U1.23
LCD_BL: J1.18, R29.1
LCD_BLK: J3.8, R29.2
LCD_CS: J1.6, J3.7
LCD_DC: J1.7, J3.6
LCD_MOSI: J1.5, J3.4
LCD_RST: J1.8, J3.5
LCD_SCK: J1.3, J3.3
LED_CC_K: D3.1, U1.15
LED_CV_K: D4.1, U1.16
LED_FAULT_K: D5.1, U1.17
LED_OE_K: J6.4, U1.13
unnamed: TP3.1, U1.11
unnamed: D3.2, R18.2
unnamed: D4.2, R19.2
unnamed: D5.2, R20.2
unnamed: TP4.1, U1.14
OE_BTN: C10.1, J1.17, R24.2
OE_BTN_RAW: J6.1, R23.2, R24.1
OE_LED_A: J6.3, R27.2
UI_INT: J1.12, U1.1
