GarryBGoode/VibeSupply/kicad/supply_control/supply_control.kicad_pcb

## KiCad design kicad/supply_control/supply_control.kicad_pcb (2026-10-05)

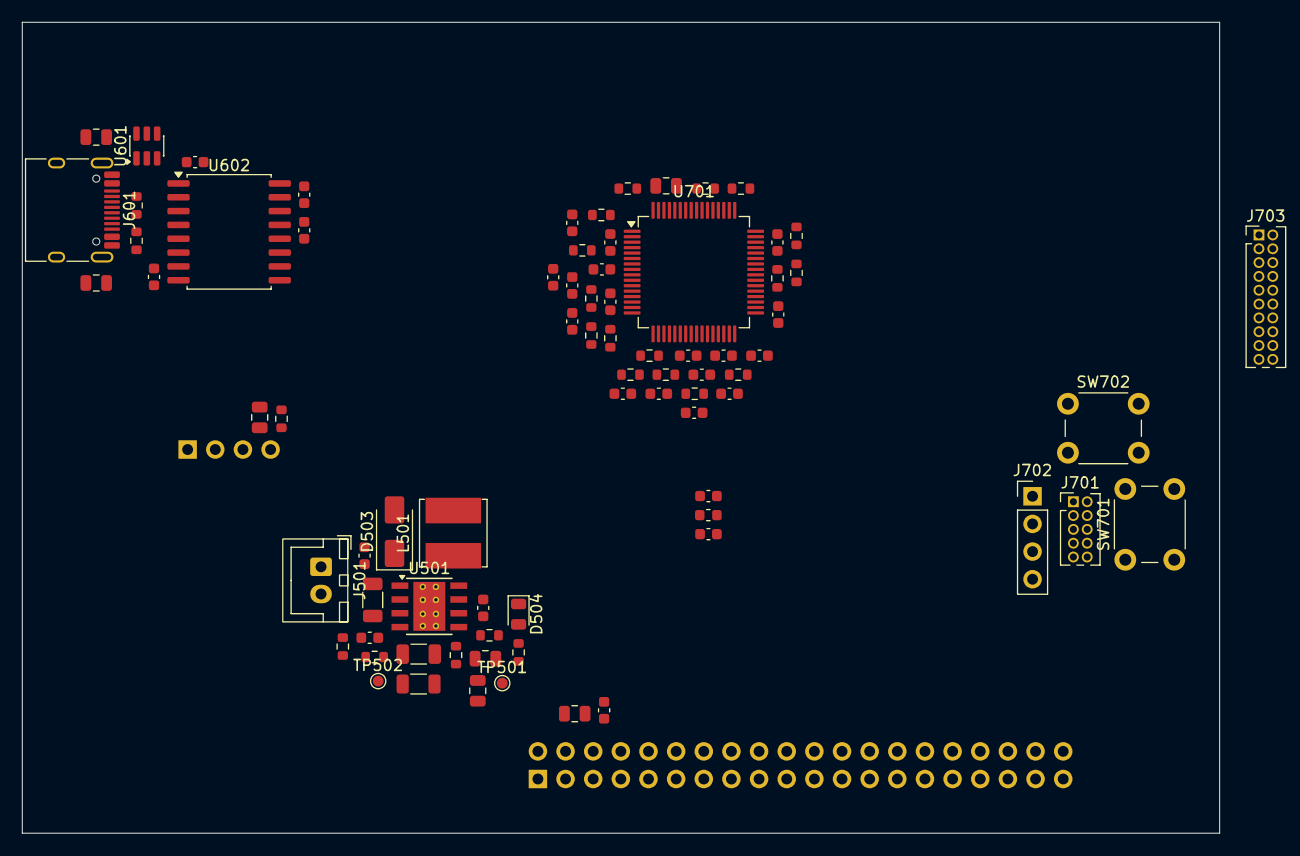
[picture p20: board supply_control.kicad_pcb from above]

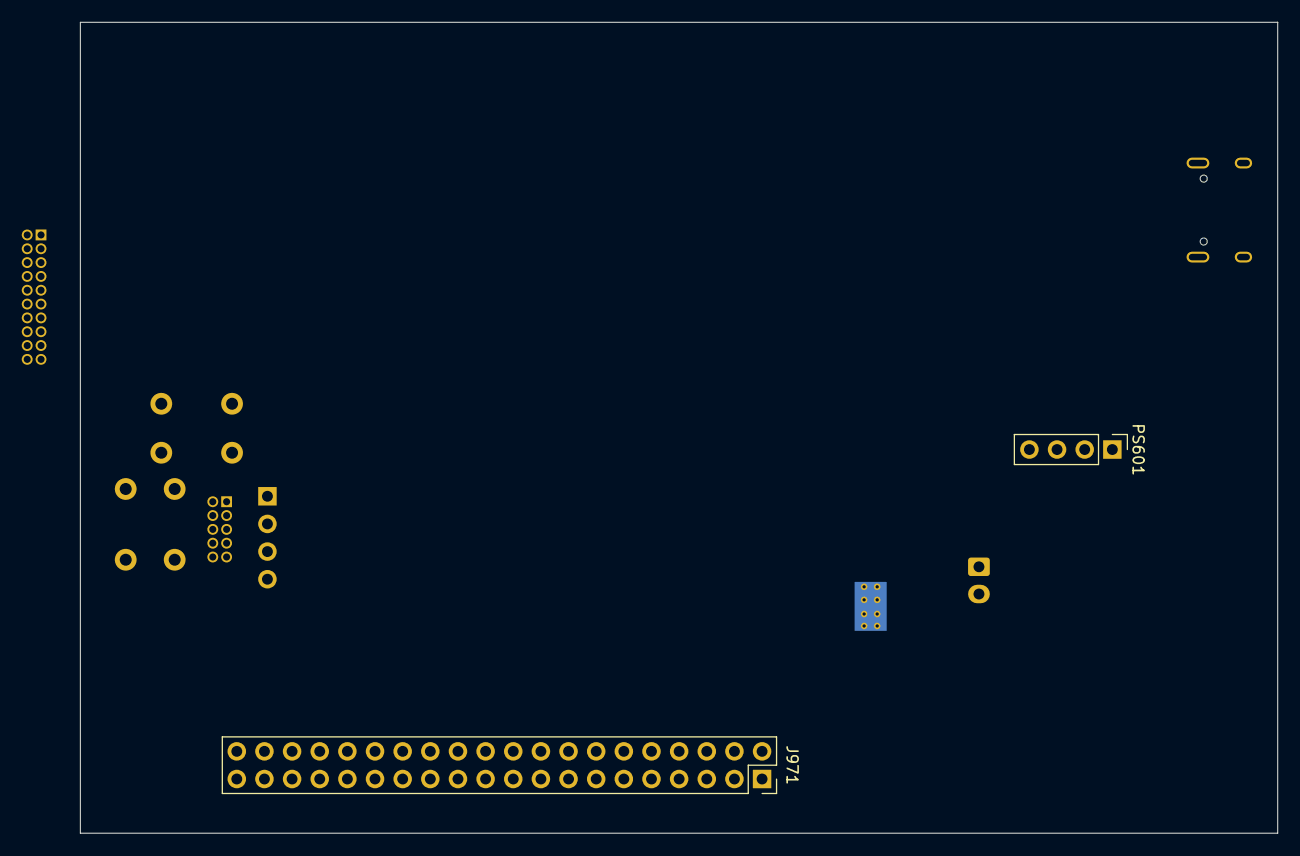
[picture p21: board supply_control.kicad_pcb from below]

Board: 4 copper layers, 110.0 x 74.5 mm, 80 parts (2 on the bottom side), 77 nets, no tracks yet.

Parts:
C501, C502: 2.2u; C_1206_3216Metric
C503, C504, C508, C604, C605, C701, C702, C703, C704, C706, C708, C709, C972: 100n; C_0603_1608Metric
C505, C506: 22u; C_0805_2012Metric
C507, C602, C603, C707: 1u; C_0603_1608Metric
C509: 10n; C_0603_1608Metric
C601, C606, C607, C705, C971: 4.7u; C_0805_2012Metric
C710, C711, C712, C713, C714, C715, C716, C717, C718: 1n; C_0603_1608Metric
D503: SS14; D_SMA
D504: green; LED_0805_2012Metric
FB501: 600R@100MHz; L_0603_1608Metric
J501: POWER rocker; JST_XH_B2B-XH-A_1x02_P2.50mm_Vertical
J601: USB_C_Receptacle_USB2.0_16P; USB_C_Receptacle_HRO_TYPE-C-31-M-12
J701: SWD; PinHeader_2x05_P1.27mm_Vertical
J702: UART; PinHeader_1x04_P2.54mm_Vertical
J703: UI ribbon; PinHeader_2x10_P1.27mm_Vertical
J971: B2B to supply_power; PinSocket_2x20_P2.54mm_Vertical
L501: 22uH; L_Bourns_SRN6045TA
PS601: B0505S-1WR3; PinHeader_1x04_P2.54mm_Vertical
R501: 66.5k; R_0603_1608Metric
R502: 23.2k; R_0603_1608Metric
R503, R701, R706, R707: 10k; R_0603_1608Metric
R504: 1k; R_0603_1608Metric
R505: 4.7k; R_1206_3216Metric
R506: 47k; R_0603_1608Metric
R601, R602: 5.1k; R_0603_1608Metric
R603, R704, R705: 2.2k; R_0603_1608Metric
R702, R703: 4.7k; R_0603_1608Metric
R708, R709, R710, R711, R712, R713, R714, R715, R716: 100; R_0603_1608Metric
SW701: RESET; SW_PUSH_6mm
SW702: BOOT; SW_PUSH_6mm
TP501, TP502: TestPoint; TestPoint_Pad_D1.0mm
U501: LMR38010; TI_SO-PowerPAD-8_ThermalVias
U601: USBLC6-2SC6; SOT-23-6
U602: ADUM3160; SOIC-16W_7.5x10.3mm_P1.27mm
U701: STM32G474RETx; LQFP-64_10x10mm_P0.5mm

Connections:
+3V3: C505.1, C506.1, C603.1, C605.1, C701.1, C702.1, C703.1, C704.1, C705.1, C971.1, C972.1, FB501.1, J701.1, J702.1, J703.1, J703.20, J971.5, J971.6, L501.2, R502.1, R504.1, R702.1, R703.1, R704.1, R705.1, R706.1, R707.1, SW702.2, TP501.1, U602.12, U602.13, U602.14, U602.16, U701.1, U701.16, U701.32, U701.48, U701.64
+3V3A: C507.1, C508.1, C706.1, FB501.2, U701.29
+5V_ISO: C607.1, D503.2, PS601.4, R603.1
BOOT0: R701.1, SW702.1, U701.61
BUCK_PSKIP: J971.15, U701.36
BUCK_RUN: J971.16, U701.34
BUZZER: J703.19, U701.21
CLAMP_DIS: J971.18, U701.59
DAC_I: J971.26, U701.19
DAC_ICL: J971.28, U701.20
DAC_V: J971.24, U701.18
DCIN_ON: J971.21, U701.57
ENC1_A: J703.13, U701.38
ENC1_B: J703.14, U701.39
ENC2_A: J703.15, U701.8
ENC2_B: J703.16, U701.9
FAULT: J971.17, U701.4
GND: C501.2, C502.2, C503.2, C505.2, C506.2, C507.2, C508.2, C509.2, C603.2, C605.2, C607.2, C701.2, C702.2, C703.2, C704.2, C705.2, C706.2, C707.2, C708.2, C709.2, C710.2, C711.2, C712.2, C713.2, C714.2, C715.2, C716.2, C717.2, C718.2, C971.2, C972.2, D504.1, J701.3, J701.5, J701.9, J702.4, J703.2, J703.4, J703.9, J971.1, J971.3, J971.4, J971.7, J971.8, J971.22, J971.23, J971.25, J971.27, J971.33, J971.39, J971.40, PS601.3, R501.2, R503.2, R506.2, R603.2, R701.2, SW701.2, U501.1, U501.9, U602.9, U602.15, U701.15, U701.27, U701.31, U701.47, U701.63
GND_ISO: C601.2, C602.2, C604.2, C606.2, J601.A1, J601.A12, J601.B1, J601.B12, J601.SH, PS601.1, R601.2, R602.2, U601.2, U602.2, U602.8
I2C1_SCL: J971.10, R702.2, U701.51
I2C1_SDA: J971.9, R703.2, U701.60
I2C2_SCL: J703.10, R704.2, U701.43
I2C2_SDA: J703.11, R705.2, U701.42
IL_SNS: J971.29, R711.1
IL_SNS_MCU: C713.1, R711.2, U701.24
INA_ALERT: J971.11, R707.2, U701.3
ISO_CC1: J601.A5, R601.1
ISO_CC2: J601.B5, R602.1
ISO_UD+: J601.A6, J601.B6, U601.1, U601.6, U602.7
ISO_UD-: J601.A7, J601.B7, U601.3, U601.4, U602.6
ISO_VDD1: C602.1, C604.1, U602.3, U602.4, U602.5
ITH_MON: J971.34, R713.1
ITH_MON_MCU: C715.1, R713.2, U701.10
LCD_BL: J703.18, U701.30
LCD_CS: J703.6, U701.40
LCD_DC: J703.7, U701.41
LCD_MOSI: J703.5, U701.37
LCD_RST: J703.8, U701.54
LCD_SCK: J703.3, U701.35
LOGIC_IN: C501.1, C502.1, C503.1, D503.1, J971.2, R505.1, U501.3
LOG_BOOT: C504.1, U501.7
LOG_EN: C509.1, J501.2, R506.1, TP502.1, U501.2
LOG_FB: R502.2, R503.1, U501.5
LOG_SW: C504.2, L501.1, U501.8
unnamed: J501.1, R505.2
unnamed: R501.1, U501.4
unnamed: D504.2, R504.2
unnamed: J701.2, U701.49
unnamed: J701.4, U701.50
NRST: C709.1, J701.10, SW701.1, U701.7
NTC_CLAMP: J971.38, R716.1
NTC_CLAMP_MCU: C718.1, R716.2, U701.23
NTC_FET: J971.36, R714.1
NTC_FET_MCU: C716.1, R714.2, U701.11
NTC_IND: J971.35, R715.1
NTC_IND_MCU: C717.1, R715.2, U701.22
NTC_OUTSW: J971.37, R712.1
NTC_OUTSW_MCU: C714.1, R712.2, U701.26
OCP_FLT: J971.19, U701.25
OE_BTN: J703.17, U701.55
OUT_EN: J971.13, U701.58
OVP_FLT: J971.20, U701.12
PD_IRQ: J971.12, U701.62
PD_SINK_EN: J971.14, U701.56
UART_RX: J702.3, U701.53
UART_TX: J702.2, U701.52
UI_INT: J703.12, R706.2, U701.44
USB_DM: U602.11, U701.45
USB_DP: U602.10, U701.46
VBUS_PC: C601.1, C606.1, J601.A4, J601.A9, J601.B4, J601.B9, PS601.2, U601.5, U602.1
VIN_SNS: J971.31, R710.1
VIN_SNS_MCU: C712.1, R710.2, U701.17
VOUT_SNS: J971.30, R708.1
VOUT_SNS_MCU: C710.1, R708.2, U701.13
VREF+: C707.1, C708.1, U701.28
VTERM_SNS: J971.32, R709.1
VTERM_SNS_MCU: C711.1, R709.2, U701.14
