GarryBGoode/VibeSupply/kicad/supply_power/supply_power.kicad_pcb

## KiCad design kicad/supply_power/supply_power.kicad_pcb (2026-10-02)

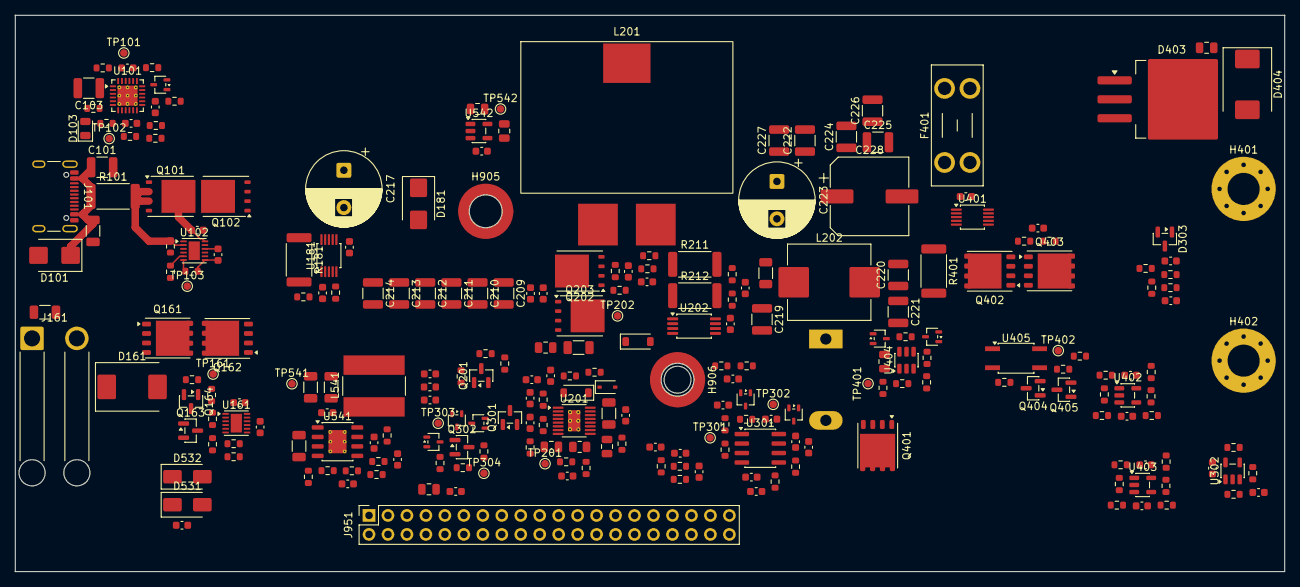
[picture p22: board supply_power.kicad_pcb from above]

Board: 4 copper layers, 170.0 x 74.5 mm, 253 parts (1 on the bottom side), 125 nets.

Parts:
C101, C103, C209, C210, C211, C212, C213, C214, C219, C220, C221, C222, C224, C225, C226, C227: 4.7u; C_1210_3225Metric
C102, C161, C201: 1u; C_1206_3216Metric
C104, C305, C532: 1u; C_0603_1608Metric
C105, C106, C107, C108, C162, C163, C181, C182, C207, C215, C216, C229, C231, C232, C301, C302, C304, C313, C314, C401, C403, C405, C408, C409, C531, C533, C542, C952: 100n; C_0603_1608Metric
C202, C406, C549: 1u; C_0805_2012Metric
C203, C951: 4.7u; C_0805_2012Metric
C204, C218, C230, C310, C402, C404, C545: 1n; C_0603_1608Metric
C205: 100p; C_0603_1608Metric
C206, C303, C311, C312, C548: 10n; C_0603_1608Metric
C208: 1n; C_0805_2012Metric
C217: 100u 100V; CP_Radial_D10.0mm_P5.00mm
C223: 100u 63V; CP_Radial_D10.0mm_P5.00mm
C228: 100u 63V; CP_Elec_10x12.6
C306, C309: 1.3n; C_0603_1608Metric
C307: 68p; C_0603_1608Metric
C308: 27n; C_0603_1608Metric
C407: 100n; C_0805_2012Metric
C541: 2.2u; C_1206_3216Metric
C543: 2.2n; C_0603_1608Metric
C544: 3.3n; C_0603_1608Metric
C546, C547: 10u; C_1206_3216Metric
C550: 2.2u; C_0805_2012Metric
D101: SMBJ30A; D_SMB
D102, D301, D302, D304, D305, D306, D401, D402: BAT54W; SOT-323_SC-70
D103: green; LED_0805_2012Metric
D161, D404: SMCJ54A; D_SMC
D162: BZT52C12; D_SOD-123
D181: SMBJ33A; D_SMB
D201: BZT52C36; D_SOD-123
D202: CMDSH-4E; D_SOD-323
D303: BAT54S; SOT-23
D403: MBRB40100CT; TO-263-3_TabPin2
D531, D532: SS110; D_SMA
F401: 15A 32V MINI; Fuseholder_Blade_Mini_Keystone_3568
FB531: 600R@100MHz; L_0603_1608Metric
H401: POST+; MountingHole_4.3mm_M4_Pad_Via
H402: POST-; MountingHole_4.3mm_M4_Pad_Via
H905: GND screw (M3 insert); Mounting_Wuerth_WA-SMSI-M3_H3mm_9774030360
H906: LTO100 screw (M3 insert); Mounting_Wuerth_WA-SMSI-M3_H3mm_9774030360
J101: USB_C_Receptacle_USB2.0_16P; USB_C_Receptacle_GCT_USB4105-xx-A_16P_TopMnt_Horizontal
J161: DC IN wires; SolderWire-1.5sqmm_1x02_P6mm_D1.7mm_OD3mm_Relief
J951: B2B to supply_control; PinSocket_2x20_P2.54mm_Vertical
L201: 10uH SER2918H-103KL; L_Coilcraft_SER2918H
L202: 0.47uH; L_Changjiang_FXL1040
L541: 68uH; L_Bourns-SRN8040_8x8.15mm
Q101, Q102: CSD18540Q5B; TDSON-8-1
Q161, Q162: ISC030N10NM6; Infineon_PG-TDSON-8_6.15x5.15mm
Q163, Q164, Q201, Q302, Q404, Q405: 2N7002; SOT-23
Q202, Q203: CSD18531Q5A; TDSON-8-1
Q301: BC857; SOT-23
Q401, Q402, Q403: BSC040N10NS5; Infineon_PG-TDSON-8_6.15x5.15mm
R101: 5m; R_2512_6332Metric
R102: 200; R_0603_1608Metric
R103, R104: 5.1k; R_0603_1608Metric
R105, R108, R109, R163, R166, R207, R309, R317, R319, R414, R415, R418, R422, R541, R543: 100k; R_0603_1608Metric
R106, R107, R205, R206, R301, R302: 1k; R_0603_1608Metric
R110, R161: 243k; R_0603_1608Metric
R111, R162, R183, R203, R217, R218, R219, R305, R307, R311, R313, R314, R316, R318, R403, R404, R409, R410, R421, R423, R424, R545: 10k; R_0603_1608Metric
R164: 15k; R_0603_1608Metric
R165, R407, R413: 1M; R_0603_1608Metric
R181, R401: 1m; R_2512_6332Metric
R182, R408: 120k; R_0603_1608Metric
R201: 10; R_0805_2012Metric
R202: 61.9k; R_0603_1608Metric
R204: 124k; R_0603_1608Metric
R208: 1; R_0603_1608Metric
R209: 0; R_0603_1608Metric
R210: 2.2; R_1206_3216Metric
R211, R212: 4m; R_2512_6332Metric
R213, R214: 10; R_0603_1608Metric
R215: 0.1; R_1206_3216Metric
R216, R406, R412: 4.7k; R_0603_1608Metric
R303: 100; R_0603_1608Metric
R304, R402: 91.9k; R_0603_1608Metric
R306: 47.5k; R_0603_1608Metric
R308: 2.4k; R_0603_1608Metric
R310, R312: 110k; R_0603_1608Metric
R315: 11.5k; R_0603_1608Metric
R405, R546: 470k; R_0603_1608Metric
R411: 10.2k; R_0603_1608Metric
R416: 4.7; R_0603_1608Metric
R417: 2.2; R_0603_1608Metric
R419: 2R 100W LTO100; TO-247-2_Horizontal_TabDown
R420: 91; R_0603_1608Metric
R542: 22k; R_0603_1608Metric
R544: 90.9k; R_0603_1608Metric
TH101, TH201, TH202, TH401, TH402: 10k B3950; R_0603_1608Metric
TP101, TP102, TP103, TP161, TP201, TP202, TP301, TP302, TP303, TP304, TP401, TP402, TP541, TP542: TestPoint; TestPoint_Pad_D1.0mm
U101: AP33772S; QFN-24-1EP_4x4mm_P0.5mm_EP2.7x2.7mm_ThermalVias
U102, U161: LM74800; WSON-12-1EP_3x3mm_P0.5mm_EP1.5x2.5mm
U181, U401: INA228; TSSOP-10_3x3mm_P0.5mm
U201: LTC7803; MSOP-16-1EP_3x4.039mm_P0.5mm_EP1.651x2.845mm_ThermalVias
U202: INA240A3PW; TSSOP-8_4.4x3mm_P0.65mm
U301: ADA4522-2; SOIC-8_3.9x4.9mm_P1.27mm
U302, U402, U403: LMV331; SOT-23-5
U404: UCC27511ADBV; SOT-23-6
U405: VOM1271; SO-4_4.4x3.6mm_P2.54mm
U541: LM5164DDA; HSOP-8-1EP_3.9x4.9mm_P1.27mm_EP2.41x3.1mm_ThermalVias
U542: LP2985-5.0; SOT-23-5

Connections:
+3V3: C181.1, C401.1, C951.1, C952.1, FB531.1, J951.5, J951.6, R207.1, R316.1, R420.1, U181.6, U401.2, U401.6
+3V3A: C532.1, C533.1, D303.2, FB531.2, R218.1, R219.1, R423.1, R424.1
+5VA: C229.1, C304.1, C305.1, C314.1, C403.1, C405.1, C550.1, D102.1, R314.1, R405.1, R406.1, R410.1, R412.1, TP542.1, U202.5, U301.8, U302.5, U402.5, U403.5, U542.5
+12V_AUX: C202.1, C406.1, C544.2, C546.1, C547.1, C549.1, L541.2, R544.1, TP541.1, U201.11, U404.1, U542.1, U542.3
AUX_BST: C543.1, U541.7
AUX_EN: R541.2, R542.1, U541.3
AUX_FB: C545.2, R544.2, R545.1, U541.5
AUX_RA: C544.1, C545.1, R546.2
AUX_SW: C543.2, L541.1, R546.1, U541.8
BUCK_BG: R209.1, U201.13
BUCK_BOOST: C207.1, D202.1, U201.14
BUCK_INTVCC: C203.1, D202.2, R202.1, R205.1, U201.10
BUCK_MODE: R205.2, R206.1, U201.9
BUCK_MODE_LO: Q201.3, R206.2
BUCK_PSKIP: J951.16, Q201.1, R207.2
BUCK_RUN: J951.15, R318.1
BUCK_SENSE_N: C218.2, R214.2, U201.3
BUCK_SENSE_P: C218.1, R213.2, U201.2
BUCK_SS: C206.1, U201.1
BUCK_TG: R208.1, U201.15
BUCK_VFB: C204.1, R202.2, R203.1, U201.4
BUCK_VINC: C201.1, D201.1, R201.2, U201.12
CC_M: C309.1, R307.2, R308.1, U301.6
CC_OUT: D302.3, TP302.1, U301.7
CC_Z: C308.1, R308.2
CLAMP_BUS_CMP: D402.1, R412.2, R413.1, U403.4
CLAMP_BUS_REF: R410.2, R411.1, U403.3
CLAMP_BUS_SNS: C404.1, R408.2, R409.1, R413.2, U403.1
CLAMP_CMP: D401.1, R406.2, R407.1, U402.4
CLAMP_DIS: J951.17, R415.1, U404.5
CLAMP_G: Q401.4, R416.2, R417.2, R418.1, TP401.1
CLAMP_IN: D401.3, D402.3, R414.1, U404.6
CLAMP_R: Q401.5, R419.2
CLAMP_REF: R404.2, R405.2, U402.3
CLAMP_SNS: C402.1, R402.2, R403.1, R407.2, U402.1
CV_M: C307.1, R304.2, R305.1, R306.1, U301.2
CV_OUT: D301.3, TP301.1, U301.1
CV_Z: C306.1, R306.2
DACICL_F: C303.1, Q301.1, R303.2
DACI_F: C302.1, R302.2, U301.5
DACV_F: C301.1, R301.2, R404.1, U301.3
DAC_I: J951.25, R302.1
DAC_ICL: J951.27, R303.1
DAC_V: J951.23, R301.1
DCIN_EN: Q163.3, R163.2, R164.1, U161.6
DCIN_HOLD: D162.1, Q163.1, Q164.3, R165.2
DCIN_MID: C162.1, C163.2, Q161.5, Q162.5, R163.1, U161.3, U161.10, U161.12
DCIN_ON: J951.22, Q164.1, R166.1, TP161.1
DCIN_RAW: C161.1, D161.1, D532.2, J161.1, Q161.1, Q161.2, Q161.3, U161.2
FAULT: D304.3, D305.3, D306.3, J951.18, Q302.1, Q405.1, R317.1, TP303.1
GND: C101.2, C102.2, C103.2, C104.2, C105.2, C106.2, C107.2, C161.2, C162.2, C181.2, C182.2, C201.2, C202.2, C203.2, C204.2, C205.2, C206.2, C208.2, C209.2, C210.2, C211.2, C212.2, C213.2, C214.2, C215.2, C216.2, C217.2, C219.2, C220.2, C221.2, C222.2, C223.2, C224.2, C225.2, C226.2, C227.2, C228.2, C229.2, C230.2, C231.2, C232.2, C301.2, C302.2, C303.2, C304.2, C305.2, C310.2, C311.2, C312.2, C313.2, C314.2, C401.2, C402.2, C403.2, C404.2, C405.2, C406.2, C407.2, C408.2, C409.2, C531.2, C532.2, C533.2, C541.2, C542.2, C546.2, C547.2, C548.2, C549.2, C550.2, C951.2, C952.2, D101.2, D103.1, D161.2, D162.2, D181.2, D201.2, D303.1, D403.1, D403.3, D404.2, H402.1, H905.1, H906.1, J101.A1, J101.A12, J101.B1, J101.B12, J101.SH, J161.2, J951.2, J951.3, J951.4, J951.7, J951.8, J951.21, J951.24, J951.26, J951.28, J951.34, J951.39, J951.40, Q163.2, Q164.2, Q201.2, Q203.1, Q203.2, Q203.3, Q301.3, Q302.2, Q401.1, Q401.2, Q401.3, Q404.2, Q405.2, R103.2, R104.2, R105.2, R108.2, R109.2, R111.2, R162.2, R164.2, R166.2, R183.2, R203.2, R204.2, R217.2, R305.2, R311.2, R313.2, R315.2, R317.2, R319.2, R403.2, R409.2, R411.2, R414.2, R415.2, R418.2, R422.2, R542.2, R543.2, R545.2, TH101.2, TH201.2, TH202.2, TH401.2, TH402.2, U101.3, U101.25, U102.7, U161.7, U181.1, U181.2, U181.7, U201.8, U201.17, U202.1, U202.4, U202.6, U202.7, U301.4, U302.2, U401.1, U401.7, U402.2, U403.2, U404.4, U541.1, U541.9, U542.2
HW_OVP: D306.1, R316.2, U302.4
HW_OVP_REF: C313.1, R314.2, R315.1, U302.3
I2C1_SCL: J951.9, U101.5, U181.5, U401.5
I2C1_SDA: J951.10, U101.4, U181.4, U401.4
IL_AMP: R216.1, R307.1, U202.8
IL_SENSE+: L201.2, R211.1, R212.1, R213.1, U202.2
IL_SNS: C230.1, J951.30, R216.2, R217.1
INA_ALERT: J951.12, U181.3, U401.3
ITH: C205.1, C306.2, C307.2, C308.2, C309.2, D301.1, D302.1, Q301.2, R309.1, TP201.1, U201.5
ITH_MON: C310.1, J951.33, R309.2
LOGIC_IN: C531.1, D531.1, D532.1, J951.1, R165.1
unnamed: R102.2, U101.22
unnamed: TP101.1, U101.23
unnamed: C105.1, U101.12
unnamed: C106.1, U101.15
unnamed: TH101.1, U101.13
unnamed: R105.1, U101.11
unnamed: R106.1, U101.8
unnamed: D103.2, R106.2
unnamed: TP102.1, U101.6
unnamed: R107.1, U101.9
unnamed: Q101.4, U102.1
unnamed: Q102.4, U102.8
unnamed: C108.1, U102.11
unnamed: R110.1, U102.4
unnamed: R110.2, R111.1, U102.5
unnamed: Q161.4, U161.1
unnamed: Q162.4, U161.8
unnamed: C163.1, U161.11
unnamed: R161.1, U161.4
unnamed: R161.2, R162.1, U161.5
unnamed: R204.1, U201.7
unnamed: Q202.4, R208.2
unnamed: Q203.4, R209.2
unnamed: C208.1, R210.2
unnamed: R416.1, U404.2
unnamed: R417.1, U404.3
unnamed: R543.1, U541.4
unnamed: C548.1, U542.4
NTC_CLAMP: C408.1, J951.37, R423.2, TH401.1
NTC_FET: C231.1, J951.35, R218.2, TH201.1
NTC_IND: C232.1, J951.36, R219.2, TH202.1
NTC_OUTSW: C409.1, J951.38, R424.2, TH402.1
OCP_FLT: D305.1, J951.20
OE_G: Q404.1, Q405.3, R421.2, R422.1
OE_LED_A: R420.2, U405.1
OE_LED_K: Q404.3, U405.2
OUT+: C407.1, D403.2, D404.1, F401.2, H401.1, R312.1
OUTSW_G: Q402.4, Q403.4, TP402.1, U405.4
OUTSW_MID: Q402.1, Q402.2, Q402.3, Q403.1, Q403.2, Q403.3, U405.3
OUT_EN: J951.14, R421.1
OVP_FLT: D304.1, J951.19
PD_CC1: J101.A5, R103.1, U101.17
PD_CC2: J101.B5, R104.1, U101.16
PD_DN: J101.A7, J101.B7, U101.18
PD_DP: J101.A6, J101.B6, U101.19
PD_IRQ: J951.11, R107.2, R108.1
PD_SINK_EN: J951.13, R109.1, TP103.1, U102.6
PD_V5V: C104.1, D102.3, U101.20
RUN: Q302.3, R318.2, R319.1, TP304.1, U201.6
SW: C207.2, L201.1, Q202.1, Q202.2, Q202.3, Q203.5, R210.1, TP202.1, U201.16
USBIN_MID: C107.1, C108.2, Q101.5, Q102.5, U102.3, U102.10, U102.12
VBUS_RAW: C101.1, C102.1, D101.1, D531.2, J101.A4, J101.A9, J101.B4, J101.B9, R101.1, U101.24
VBUS_S: C103.1, Q101.1, Q101.2, Q101.3, R101.2, R102.1, U101.1, U102.2
VC1: C219.1, C220.1, C221.1, C222.1, L202.1, R211.2, R212.2, R214.1, R215.1, U202.3
VC1_DAMP: C223.1, R215.2
VIN_BUS: Q102.1, Q102.2, Q102.3, Q162.1, Q162.2, Q162.3, R181.1, U102.9, U161.9, U181.10
VIN_PWR: C209.1, C210.1, C211.1, C212.1, C213.1, C214.1, C215.1, C216.1, C217.1, C541.1, C542.1, D181.1, Q202.5, R181.2, R182.1, R201.1, R408.1, R541.1, U181.8, U181.9, U541.2
VIN_SNS: C182.1, J951.32, R182.2, R183.1
VOUT_INT: C224.1, C225.1, C226.1, C227.1, C228.1, L202.2, R304.1, R310.1, R401.1, U401.10
VOUT_SH: Q402.5, R401.2, R402.1, R419.1, U401.8, U401.9
VOUT_SNS: C311.1, J951.29, R310.2, R311.1, U302.1
VTERM: F401.1, Q403.5
VTERM_SNS: C312.1, D303.3, J951.31, R312.2, R313.1
