GarryBGoode/VibeSupply/control_design_sklib.py

from collections import defaultdict
from skidl import Pin, Part, Alias, SchLib, SKIDL, TEMPLATE

from skidl.pin import pin_types

SKIDL_lib_version = '0.0.1'

control_design = SchLib(tool=SKIDL).add_parts(*[
        Part(**{ 'name':'D_Schottky', 'dest':TEMPLATE, 'tool':SKIDL, 'aliases':Alias({'D_Schottky'}), 'ref_prefix':'D', 'fplist':[''], 'footprint':'Diode_SMD:D_SMA', 'keywords':'diode Schottky', 'description':'Schottky diode', 'datasheet':'', 'pins':[
            Pin(num='1',name='K',func=pin_types.PASSIVE,unit=1),
            Pin(num='2',name='A',func=pin_types.PASSIVE,unit=1)], 'unit_defs':[] }),
        Part(**{ 'name':'C', 'dest':TEMPLATE, 'tool':SKIDL, 'aliases':Alias({'C'}), 'ref_prefix':'C', 'fplist':[''], 'footprint':'Capacitor_SMD:C_1206_3216Metric', 'keywords':'cap capacitor', 'description':'Unpolarized capacitor', 'datasheet':'', 'pins':[
            Pin(num='1',func=pin_types.PASSIVE,unit=1),
            Pin(num='2',func=pin_types.PASSIVE,unit=1)], 'unit_defs':[] }),
        Part(**{ 'name':'LMR38010', 'dest':TEMPLATE, 'tool':SKIDL, 'aliases':Alias({'LMR38010'}), 'ref_prefix':'U', 'fplist':['Package_SO:TI_SO-PowerPAD-8_ThermalVias'], 'footprint':'Package_SO:TI_SO-PowerPAD-8_ThermalVias', 'keywords':'', 'description':'4.2-80 V 1 A synchronous buck', 'datasheet':'', 'pins':[
            Pin(num='1',name='GND',func=pin_types.PWRIN,unit=1),
            Pin(num='2',name='EN',func=pin_types.INPUT,unit=1),
            Pin(num='3',name='VIN',func=pin_types.PWRIN,unit=1),
            Pin(num='4',name='RT',func=pin_types.PASSIVE,unit=1),
            Pin(num='5',name='FB',func=pin_types.INPUT,unit=1),
            Pin(num='6',name='PG',func=pin_types.OPENCOLL,unit=1),
            Pin(num='7',name='BOOT',func=pin_types.PASSIVE,unit=1),
            Pin(num='8',name='SW',func=pin_types.PWROUT,unit=1),
            Pin(num='9',name='EP',func=pin_types.PWRIN,unit=1)], 'unit_defs':[] }),
        Part(**{ 'name':'Conn_01x02', 'dest':TEMPLATE, 'tool':SKIDL, 'aliases':Alias({'Conn_01x02'}), 'ref_prefix':'J', 'fplist':[''], 'footprint':'Connector_JST:JST_XH_B2B-XH-A_1x02_P2.50mm_Vertical', 'keywords':'connector', 'description':'Generic connector, single row, 01x02, script generated (kicad-library-utils/schlib/autogen/connector/)', 'datasheet':'', 'pins':[
            Pin(num='1',name='Pin_1',func=pin_types.PASSIVE,unit=1),
            Pin(num='2',name='Pin_2',func=pin_types.PASSIVE,unit=1)], 'unit_defs':[] }),
        Part(**{ 'name':'R', 'dest':TEMPLATE, 'tool':SKIDL, 'aliases':Alias({'R'}), 'ref_prefix':'R', 'fplist':[''], 'footprint':'Resistor_SMD:R_1206_3216Metric', 'keywords':'R res resistor', 'description':'Resistor', 'datasheet':'', 'pins':[
            Pin(num='1',func=pin_types.PASSIVE,unit=1),
            Pin(num='2',func=pin_types.PASSIVE,unit=1)], 'unit_defs':[] }),
        Part(**{ 'name':'TestPoint', 'dest':TEMPLATE, 'tool':SKIDL, 'aliases':Alias({'TestPoint'}), 'ref_prefix':'TP', 'fplist':[''], 'footprint':'TestPoint:TestPoint_Pad_D1.0mm', 'keywords':'test point tp', 'description':'test point', 'datasheet':'', 'pins':[
            Pin(num='1',name='1',func=pin_types.PASSIVE,unit=1)], 'unit_defs':[] }),
        Part(**{ 'name':'L', 'dest':TEMPLATE, 'tool':SKIDL, 'aliases':Alias({'L'}), 'ref_prefix':'L', 'fplist':[''], 'footprint':'Inductor_SMD:L_Bourns_SRN6045TA', 'keywords':'inductor choke coil reactor magnetic', 'description':'Inductor', 'datasheet':'', 'pins':[
            Pin(num='1',name='1',func=pin_types.PASSIVE,unit=1),
            Pin(num='2',name='2',func=pin_types.PASSIVE,unit=1)], 'unit_defs':[] }),
        Part(**{ 'name':'FerriteBead_Small', 'dest':TEMPLATE, 'tool':SKIDL, 'aliases':Alias({'FerriteBead_Small'}), 'ref_prefix':'FB', 'fplist':[''], 'footprint':'Inductor_SMD:L_0603_1608Metric', 'keywords':'L ferrite bead inductor filter', 'description':'Ferrite bead, small symbol', 'datasheet':'', 'pins':[
            Pin(num='1',func=pin_types.PASSIVE,unit=1),
            Pin(num='2',func=pin_types.PASSIVE,unit=1)], 'unit_defs':[] }),
        Part(**{ 'name':'LED', 'dest':TEMPLATE, 'tool':SKIDL, 'aliases':Alias({'LED'}), 'ref_prefix':'D', 'fplist':[''], 'footprint':'LED_SMD:LED_0805_2012Metric', 'keywords':'LED diode', 'description':'Light emitting diode', 'datasheet':'', 'pins':[
            Pin(num='1',name='K',func=pin_types.PASSIVE,unit=1),
            Pin(num='2',name='A',func=pin_types.PASSIVE,unit=1)], 'unit_defs':[] }),
        Part(**{ 'name':'USB_C_Receptacle_USB2.0_16P', 'dest':TEMPLATE, 'tool':SKIDL, 'aliases':Alias({'USB_C_Receptacle_USB2.0_16P'}), 'ref_prefix':'J', 'fplist':[''], 'footprint':'Connector_USB:USB_C_Receptacle_HRO_TYPE-C-31-M-12', 'keywords':'usb universal serial bus type-C USB2.0', 'description':'USB 2.0-only 16P Type-C Receptacle connector', 'datasheet':'https://www.usb.org/sites/default/files/documents/usb_type-c.zip', 'pins':[
            Pin(num='A1',name='GND',func=pin_types.PASSIVE,unit=1),
            Pin(num='A4',name='VBUS',func=pin_types.PASSIVE,unit=1),
            Pin(num='A5',name='CC1',func=pin_types.BIDIR,unit=1),
            Pin(num='A6',name='D+',func=pin_types.BIDIR,unit=1),
            Pin(num='A7',name='D-',func=pin_types.BIDIR,unit=1),
            Pin(num='A8',name='SBU1',func=pin_types.BIDIR,unit=1),
            Pin(num='A9',name='VBUS',func=pin_types.PASSIVE,unit=1),
            Pin(num='A12',name='GND',func=pin_types.PASSIVE,unit=1),
            Pin(num='B1',name='GND',func=pin_types.PASSIVE,unit=1),
            Pin(num='B4',name='VBUS',func=pin_types.PASSIVE,unit=1),
            Pin(num='B5',name='CC2',func=pin_types.BIDIR,unit=1),
            Pin(num='B6',name='D+',func=pin_types.BIDIR,unit=1),
            Pin(num='B7',name='D-',func=pin_types.BIDIR,unit=1),
            Pin(num='B8',name='SBU2',func=pin_types.BIDIR,unit=1),
            Pin(num='B9',name='VBUS',func=pin_types.PASSIVE,unit=1),
            Pin(num='B12',name='GND',func=pin_types.PASSIVE,unit=1),
            Pin(num='SH',name='SHIELD',func=pin_types.PASSIVE,unit=1)], 'unit_defs':[] }),
        Part(**{ 'name':'USBLC6-2SC6', 'dest':TEMPLATE, 'tool':SKIDL, 'aliases':Alias({'USBLC6-2SC6'}), 'ref_prefix':'U', 'fplist':['Package_TO_SOT_SMD:SOT-666', 'Package_TO_SOT_SMD:SOT-23-6'], 'footprint':'Package_TO_SOT_SMD:SOT-23-6', 'keywords':'usb ethernet video', 'description':'Very low capacitance ESD protection diode, 2 data-line, SOT-23-6', 'datasheet':'https://www.st.com/resource/en/datasheet/usblc6-2.pdf', 'pins':[
            Pin(num='1',name='I/O1',func=pin_types.PASSIVE,unit=1),
            Pin(num='2',name='GND',func=pin_types.PASSIVE,unit=1),
            Pin(num='3',name='I/O2',func=pin_types.PASSIVE,unit=1),
            Pin(num='4',name='I/O2',func=pin_types.PASSIVE,unit=1),
            Pin(num='5',name='VBUS',func=pin_types.PASSIVE,unit=1),
            Pin(num='6',name='I/O1',func=pin_types.PASSIVE,unit=1)], 'unit_defs':[] }),
        Part(**{ 'name':'ADUM3160', 'dest':TEMPLATE, 'tool':SKIDL, 'aliases':Alias({'ADUM3160'}), 'ref_prefix':'U', 'fplist':['Package_SO:SOIC-16W_7.5x10.3mm_P1.27mm', 'Package_SO:SOIC-16W_7.5x10.3mm_P1.27mm'], 'footprint':'Package_SO:SOIC-16W_7.5x10.3mm_P1.27mm', 'keywords':'usb isolation', 'description':'Full/Low Speed, iCoupler USB Digital Isolator, 2.5kV protection', 'datasheet':'https://www.analog.com/media/en/technical-documentation/data-sheets/ADuM3160.pdf', 'pins':[
            Pin(num='1',name='VBUS1',func=pin_types.PWRIN,unit=1),
            Pin(num='2',name='GND1',func=pin_types.PWRIN,unit=1),
            Pin(num='3',name='VDD1',func=pin_types.PWRIN,unit=1),
            Pin(num='4',name='PDEN',func=pin_types.INPUT,unit=1),
            Pin(num='5',name='SPU',func=pin_types.INPUT,unit=1),
            Pin(num='6',name='UD-',func=pin_types.BIDIR,unit=1),
            Pin(num='7',name='UD+',func=pin_types.BIDIR,unit=1),
            Pin(num='8',name='GND1',func=pin_types.PWRIN,unit=1),
            Pin(num='9',name='GND2',func=pin_types.PWRIN,unit=1),
            Pin(num='10',name='DD+',func=pin_types.BIDIR,unit=1),
            Pin(num='11',name='DD-',func=pin_types.BIDIR,unit=1),
            Pin(num='12',name='PIN',func=pin_types.INPUT,unit=1),
            Pin(num='13',name='SPD',func=pin_types.INPUT,unit=1),
            Pin(num='14',name='VDD2',func=pin_types.PWRIN,unit=1),
            Pin(num='15',name='GND2',func=pin_types.PWRIN,unit=1),
            Pin(num='16',name='VBUS2',func=pin_types.PWRIN,unit=1)], 'unit_defs':[] }),
        Part(**{ 'name':'B0505S-1WR3', 'dest':TEMPLATE, 'tool':SKIDL, 'aliases':Alias({'B0505S-1WR3'}), 'ref_prefix':'PS', 'fplist':['Connector_PinHeader_2.54mm:PinHeader_1x04_P2.54mm_Vertical'], 'footprint':'Connector_PinHeader_2.54mm:PinHeader_1x04_P2.54mm_Vertical', 'keywords':'', 'description':'1 W isolated DC-DC 5 V -> 5 V', 'datasheet':'', 'pins':[
            Pin(num='1',name='GND_IN',func=pin_types.PWRIN,unit=1),
            Pin(num='2',name='VIN',func=pin_types.PWRIN,unit=1),
            Pin(num='3',name='0V_OUT',func=pin_types.PWROUT,unit=1),
            Pin(num='4',name='VOUT',func=pin_types.PWROUT,unit=1)], 'unit_defs':[] }),
        Part(**{ 'name':'STM32G474RETx', 'dest':TEMPLATE, 'tool':SKIDL, 'aliases':Alias({'STM32G474RETx'}), 'ref_prefix':'U', 'fplist':['Package_QFP:LQFP-64_10x10mm_P0.5mm', 'Package_QFP:LQFP-64_10x10mm_P0.5mm'], 'footprint':'Package_QFP:LQFP-64_10x10mm_P0.5mm', 'keywords':'Arm Cortex-M4 STM32G4 STM32G4x4', 'description':'STMicroelectronics Arm Cortex-M4 MCU, 512KB flash, 128KB RAM, 170 MHz, 1.71-3.6V, 52 GPIO, LQFP64', 'datasheet':'https://www.st.com/resource/en/datasheet/stm32g474re.pdf', 'pins':[
            Pin(num='1',name='VBAT',func=pin_types.PWRIN,unit=1),
            Pin(num='2',name='PC13',func=pin_types.BIDIR,unit=1),
            Pin(num='3',name='PC14',func=pin_types.BIDIR,unit=1),
            Pin(num='4',name='PC15',func=pin_types.BIDIR,unit=1),
            Pin(num='5',name='PF0',func=pin_types.BIDIR,unit=1),
            Pin(num='6',name='PF1',func=pin_types.BIDIR,unit=1),
            Pin(num='7',name='PG10',func=pin_types.BIDIR,unit=1),
            Pin(num='8',name='PC0',func=pin_types.BIDIR,unit=1),
            Pin(num='9',name='PC1',func=pin_types.BIDIR,unit=1),
            Pin(num='10',name='PC2',func=pin_types.BIDIR,unit=1),
            Pin(num='11',name='PC3',func=pin_types.BIDIR,unit=1),
            Pin(num='12',name='PA0',func=pin_types.BIDIR,unit=1),
            Pin(num='13',name='PA1',func=pin_types.BIDIR,unit=1),
            Pin(num='14',name='PA2',func=pin_types.BIDIR,unit=1),
            Pin(num='15',name='VSS',func=pin_types.PWRIN,unit=1),
            Pin(num='16',name='VDD',func=pin_types.PWRIN,unit=1),
            Pin(num='17',name='PA3',func=pin_types.BIDIR,unit=1),
            Pin(num='18',name='PA4',func=pin_types.BIDIR,unit=1),
            Pin(num='19',name='PA5',func=pin_types.BIDIR,unit=1),
            Pin(num='20',name='PA6',func=pin_types.BIDIR,unit=1),
            Pin(num='21',name='PA7',func=pin_types.BIDIR,unit=1),
            Pin(num='22',name='PC4',func=pin_types.BIDIR,unit=1),
            Pin(num='23',name='PC5',func=pin_types.BIDIR,unit=1),
            Pin(num='24',name='PB0',func=pin_types.BIDIR,unit=1),
            Pin(num='25',name='PB1',func=pin_types.BIDIR,unit=1),
            Pin(num='26',name='PB2',func=pin_types.BIDIR,unit=1),
            Pin(num='27',name='VSSA',func=pin_types.PWRIN,unit=1),
            Pin(num='28',name='VREF+',func=pin_types.INPUT,unit=1),
            Pin(num='29',name='VDDA',func=pin_types.PWRIN,unit=1),
            Pin(num='30',name='PB10',func=pin_types.BIDIR,unit=1),
            Pin(num='31',name='VSS',func=pin_types.PASSIVE,unit=1),
            Pin(num='32',name='VDD',func=pin_types.PWRIN,unit=1),
            Pin(num='33',name='PB11',func=pin_types.BIDIR,unit=1),
            Pin(num='34',name='PB12',func=pin_types.BIDIR,unit=1),
            Pin(num='35',name='PB13',func=pin_types.BIDIR,unit=1),
            Pin(num='36',name='PB14',func=pin_types.BIDIR,unit=1),
            Pin(num='37',name='PB15',func=pin_types.BIDIR,unit=1),
            Pin(num='38',name='PC6',func=pin_types.BIDIR,unit=1),
            Pin(num='39',name='PC7',func=pin_types.BIDIR,unit=1),
            Pin(num='40',name='PC8',func=pin_types.BIDIR,unit=1),
            Pin(num='41',name='PC9',func=pin_types.BIDIR,unit=1),
            Pin(num='42',name='PA8',func=pin_types.BIDIR,unit=1),
            Pin(num='43',name='PA9',func=pin_types.BIDIR,unit=1),
            Pin(num='44',name='PA10',func=pin_types.BIDIR,unit=1),
            Pin(num='45',name='PA11',func=pin_types.BIDIR,unit=1),
            Pin(num='46',name='PA12',func=pin_types.BIDIR,unit=1),
            Pin(num='47',name='VSS',func=pin_types.PASSIVE,unit=1),
            Pin(num='48',name='VDD',func=pin_types.PWRIN,unit=1),
            Pin(num='49',name='PA13',func=pin_types.BIDIR,unit=1),
            Pin(num='50',name='PA14',func=pin_types.BIDIR,unit=1),
            Pin(num='51',name='PA15',func=pin_types.BIDIR,unit=1),
            Pin(num='52',name='PC10',func=pin_types.BIDIR,unit=1),
            Pin(num='53',name='PC11',func=pin_types.BIDIR,unit=1),
            Pin(num='54',name='PC12',func=pin_types.BIDIR,unit=1),
            Pin(num='55',name='PD2',func=pin_types.BIDIR,unit=1),
            Pin(num='56',name='PB3',func=pin_types.BIDIR,unit=1),
            Pin(num='57',name='PB4',func=pin_types.BIDIR,unit=1),
            Pin(num='58',name='PB5',func=pin_types.BIDIR,unit=1),
            Pin(num='59',name='PB6',func=pin_types.BIDIR,unit=1),
            Pin(num='60',name='PB7',func=pin_types.BIDIR,unit=1),
            Pin(num='61',name='PB8',func=pin_types.BIDIR,unit=1),
            Pin(num='62',name='PB9',func=pin_types.BIDIR,unit=1),
            Pin(num='63',name='VSS',func=pin_types.PASSIVE,unit=1),
            Pin(num='64',name='VDD',func=pin_types.PWRIN,unit=1)], 'unit_defs':[] }),
        Part(**{ 'name':'SW_Push', 'dest':TEMPLATE, 'tool':SKIDL, 'aliases':Alias({'SW_Push'}), 'ref_prefix':'SW', 'fplist':[''], 'footprint':'Button_Switch_THT:SW_PUSH_6mm', 'keywords':'switch normally-open pushbutton push-button', 'description':'Push button switch, generic, two pins', 'datasheet':'', 'pins':[
            Pin(num='1',name='1',func=pin_types.PASSIVE),
            Pin(num='2',name='2',func=pin_types.PASSIVE)], 'unit_defs':[] }),
        Part(**{ 'name':'Conn_02x05_Odd_Even', 'dest':TEMPLATE, 'tool':SKIDL, 'aliases':Alias({'Conn_02x05_Odd_Even'}), 'ref_prefix':'J', 'fplist':[''], 'footprint':'Connector_PinHeader_1.27mm:PinHeader_2x05_P1.27mm_Vertical', 'keywords':'connector', 'description':'Generic connector, double row, 02x05, odd/even pin numbering scheme (row 1 odd numbers, row 2 even numbers), script generated (kicad-library-utils/schlib/autogen/connector/)', 'datasheet':'', 'pins':[
            Pin(num='1',name='Pin_1',func=pin_types.PASSIVE,unit=1),
            Pin(num='2',name='Pin_2',func=pin_types.PASSIVE,unit=1),
            Pin(num='3',name='Pin_3',func=pin_types.PASSIVE,unit=1),
            Pin(num='4',name='Pin_4',func=pin_types.PASSIVE,unit=1),
            Pin(num='5',name='Pin_5',func=pin_types.PASSIVE,unit=1),
            Pin(num='6',name='Pin_6',func=pin_types.PASSIVE,unit=1),
            Pin(num='7',name='Pin_7',func=pin_types.PASSIVE,unit=1),
            Pin(num='8',name='Pin_8',func=pin_types.PASSIVE,unit=1),
            Pin(num='9',name='Pin_9',func=pin_types.PASSIVE,unit=1),
            Pin(num='10',name='Pin_10',func=pin_types.PASSIVE,unit=1)], 'unit_defs':[] }),
        Part(**{ 'name':'Conn_01x04', 'dest':TEMPLATE, 'tool':SKIDL, 'aliases':Alias({'Conn_01x04'}), 'ref_prefix':'J', 'fplist':[''], 'footprint':'Connector_PinHeader_2.54mm:PinHeader_1x04_P2.54mm_Vertical', 'keywords':'connector', 'description':'Generic connector, single row, 01x04, script generated (kicad-library-utils/schlib/autogen/connector/)', 'datasheet':'', 'pins':[
            Pin(num='1',name='Pin_1',func=pin_types.PASSIVE,unit=1),
            Pin(num='2',name='Pin_2',func=pin_types.PASSIVE,unit=1),
            Pin(num='3',name='Pin_3',func=pin_types.PASSIVE,unit=1),
            Pin(num='4',name='Pin_4',func=pin_types.PASSIVE,unit=1)], 'unit_defs':[] }),
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
            Pin(num='28',name='Pin_28',func=pin_types.PASSIVE,unit=1),
            Pin(num='29',name='Pin_29',func=pin_types.PASSIVE,unit=1),
            Pin(num='30',name='Pin_30',func=pin_types.PASSIVE,unit=1),
            Pin(num='31',name='Pin_31',func=pin_types.PASSIVE,unit=1),
            Pin(num='32',name='Pin_32',func=pin_types.PASSIVE,unit=1),
            Pin(num='33',name='Pin_33',func=pin_types.PASSIVE,unit=1),
            Pin(num='34',name='Pin_34',func=pin_types.PASSIVE,unit=1),
            Pin(num='35',name='Pin_35',func=pin_types.PASSIVE,unit=1),
            Pin(num='36',name='Pin_36',func=pin_types.PASSIVE,unit=1),
            Pin(num='37',name='Pin_37',func=pin_types.PASSIVE,unit=1),
            Pin(num='38',name='Pin_38',func=pin_types.PASSIVE,unit=1),
            Pin(num='39',name='Pin_39',func=pin_types.PASSIVE,unit=1),
            Pin(num='40',name='Pin_40',func=pin_types.PASSIVE,unit=1)], 'unit_defs':[] })])
