GarryBGoode/VibeSupply/design/housekeeping.py

"""
Housekeeping supplies. (The DNP fan header was removed 2026-09-28: fanless, board space.)

Split 2026-09-30 between the two boards (design/interconnect.py carries LOGIC_IN up and +3V3 down):
- logic_feed (supply_power): VBUS_RAW / DCIN_RAW diodes into LOGIC_IN, local +3V3A (NTC pull-ups, BAT54S clamp).
- logic_supply (supply_control): the isolated USB 5 V diode into LOGIC_IN, LMR38010 -> +3V3, +3V3A for VDDA.
- aux_supply (supply_power): LM5164 +12V_AUX, LP2985 +5VA.

- LOGIC_IN: diode-OR of raw VBUS, raw DC input and the isolated USB 5 V -> the MCU boots from any source,
  before the PD sink path is enabled (the MCU enables it after the AP33772S reports a contract).
- +3V3: LMR38010 (4.2-80 V), 400 kHz, 22 uH. Its EN goes through the panel POWER rocker (2026-10-01): rocker off = no +3V3,
  MCU unpowered, and every enable on supply_power falls back to its pull-down (buck RUN, USB sink path, output switch).
- +12V_AUX: LM5164 (6-100 V) from VIN_PWR, 300 kHz COT with type-3 ripple injection, 68 uH. LTC7803 EXTVCC
  (needs >= 7 V: at a 9 V input the rail sags to ~8.5 V, still fine), clamp gate driver, +5VA LDO.
  Enabled above ~8.3 V. Below ~9 V input the output stays off (firmware, VIN_SNS).
- +5VA: LP2985-5.0 from +12V_AUX (op-amps, INA240, comparators, AP33772S V5V backup).
- +3V3A: ferrite-filtered +3V3, made separately on each board (MCU VDDA / NTC pull-ups + VTERM_SNS clamp).
"""

from skidl import Net, Part, subcircuit

from .nets import *
from .parts import C, FB, L, LED, LMR38010, NMOS_small, R, _fields, schottky_1a, testpoint


def p3v3a_filter():
    fbd = FB()
    fbd[1, 2] += P3V3, P3V3A
    for v in ("1u", "100n"):
        c = C(v)
        c[1, 2] += P3V3A, GND


@subcircuit
def logic_feed():
    """supply_power side: the raw inputs into LOGIC_IN (goes up the B2B header), +3V3A from the +3V3 coming down."""
    for src in (VBUS_RAW, DCIN_RAW):
        d = schottky_1a("SS110")
        d["A"] += src
        d["K"] += LOGIC_IN
    c = C("100n", "0603", note="100 V")
    c[1, 2] += LOGIC_IN, GND
    p3v3a_filter()


@subcircuit
def logic_supply():
    """supply_control side: isolated USB 5 V into LOGIC_IN, LMR38010 -> +3V3, +3V3A for VDDA."""
    d = schottky_1a("SS14")
    d["A"] += P5V_ISO
    d["K"] += LOGIC_IN
    for v, size in (("2.2u", "1206"), ("2.2u", "1206"), ("100n", "0603")):
        c = C(v, size, note="100 V")
        c[1, 2] += LOGIC_IN, GND

    u = LMR38010()
    sw, bst, fb = Net("LOG_SW"), Net("LOG_BOOT"), Net("LOG_FB")
    u["VIN"] += LOGIC_IN
    # ---- POWER rocker (panel mount, wired straight to this board): closed = on. The series 4.7k limits a wire-to-case
    # short to ~6 mA at 30 V; the 47k pull-down keeps it off with the rocker open or unplugged; EN ~ 0.91 x LOGIC_IN.
    en = Net("LOG_EN")
    j = Part("Connector_Generic", "Conn_01x02", value="POWER rocker",
             footprint="Connector_JST:JST_XH_B2B-XH-A_1x02_P2.50mm_Vertical")
    _fields(j, None, "pin 1 = LOGIC_IN via 4.7k (up to ~30 V), pin 2 = LMR38010 EN")
    r_s = R("4.7k", "1206", note="wire short: 30 V / 4.7k = 6.4 mA, 0.19 W")
    LOGIC_IN & r_s & j[1]
    j[2] += en
    r_pd = R("47k")
    r_pd[1, 2] += en, GND
    c_en = C("10n", note="50 V")
    c_en[1, 2] += en, GND
    testpoint("LOG_EN")[1] += en
    u["EN"] += en
    u["GND"] += GND
    u["EP"] += GND
    u["SW"] += sw
    u["BOOT"] += bst
    u["FB"] += fb
    u["PG"] += NC
    r_rt = R("66.5k", note="400 kHz: RT = 30970 * f^-1.027")
    r_rt[1, 2] += u["RT"], GND
    c_b = C("100n")
    c_b[1, 2] += bst, sw
    l1 = L("22uH", "Inductor_SMD:L_Bourns_SRN6045TA", note="22 uH >= 1 A shielded (e.g. SRN6045TA-220M)")
    l1[1, 2] += sw, P3V3
    r_ft, r_fb = R("23.2k"), R("10k")
    P3V3 & r_ft & fb & r_fb & GND          # 1.0 V * (1 + 23.2/10) = 3.32 V
    for _ in range(2):
        co = C("22u", "0805", note="10 V")
        co[1, 2] += P3V3, GND
    testpoint("+3V3")[1] += P3V3

    # +3V3A for VDDA
    p3v3a_filter()

    # power LED
    led, rl = LED("green"), R("1k")
    P3V3 & rl & led["A"]
    led["K"] += GND


@subcircuit
def aux_supply():
    u = Part("Regulator_Switching", "LM5164DDA")
    _fields(u, "C477928")
    sw, bst, fb, en, ra = Net("AUX_SW"), Net("AUX_BST"), Net("AUX_FB"), Net("AUX_EN"), Net("AUX_RA")
    u["VIN"] += VIN_PWR
    u["GND"] += GND
    u["EP"] += GND
    u["SW"] += sw
    u["BST"] += bst
    u["FB"] += fb
    u["EN/UVLO"] += en
    u["PGOOD"] += NC
    for v, size in (("2.2u", "1206"), ("100n", "0603")):
        c = C(v, size, note="100 V")
        c[1, 2] += VIN_PWR, GND
    r_e1, r_e2 = R("100k"), R("22k")
    VIN_PWR & r_e1 & en & r_e2 & GND        # 1.5 V * 122/22 = 8.3 V
    r_on = R("100k", note="FSW(kHz) = VOUT * 2500 / RON(k) = 300 kHz")
    r_on[1, 2] += u["RON"], GND
    c_b = C("2.2n", note="50 V X7R (datasheet)")
    c_b[1, 2] += bst, sw
    l1 = L("68uH", "Inductor_SMD:L_Bourns-SRN8040_8x8.15mm", note="68 uH >= 1.2 A (e.g. SRN8040-680M)")
    l1[1, 2] += sw, P12V
    r_ft, r_fb = R("90.9k"), R("10k")
    P12V & r_ft & fb & r_fb & GND           # 1.2 V * (1 + 90.9/10) = 12.1 V
    # type-3 ripple injection (datasheet table 6-1): RA*CA >= tON*(VIN-VOUT)/20 mV
    r_a, c_a, c_bb = R("470k"), C("3.3n", note="50 V"), C("1n")
    sw & r_a & ra
    c_a[1, 2] += ra, P12V
    c_bb[1, 2] += ra, fb
    for _ in range(2):
        co = C("10u", "1206", note="25 V")
        co[1, 2] += P12V, GND
    testpoint("+12V_AUX")[1] += P12V

    # +5VA
    ldo = _fields(Part("Regulator_Linear", "LP2985-5.0"), "C74511")
    ldo["VIN"] += P12V
    ldo["ON/~{OFF}"] += P12V
    ldo["GND"] += GND
    ldo["VOUT"] += P5VA
    c_bp = C("10n")
    c_bp[1, 2] += ldo["BP"], GND
    c_i = C("1u", "0805", note="25 V")
    c_i[1, 2] += P12V, GND
    c_o = C("2.2u", "0805")
    c_o[1, 2] += P5VA, GND
    testpoint("+5VA")[1] += P5VA
