GarryBGoode/VibeSupply/(commit log)

2026-09-26 Update to 10A and 28V input
2026-09-28 status update, added lock mechanism to help link skidl modifications to layout
    [supply_main_bom.csv]
2026-10-01 Split to 2-board concept, re-generated board placements, started 3D CAD framework
    [supply_control.kicad_pcb, supply_control.kicad_sch, supply_control_bom.csv, supply_main.kicad_pcb, supply_power.kicad_pcb, supply_power.kicad_sch, supply_power_bom.csv, supply_ui_bom.csv]
2026-10-01 Created build123d assembly scripts, first 3D view or board + enclosure done
2026-10-02 added encoder model
    [supply_control.kicad_pcb, supply_control_bom.csv, supply_power.kicad_pcb, supply_power_bom.csv, supply_ui.kicad_pcb, supply_ui.kicad_sch, supply_ui_bom.csv]
2026-10-04 Improved UI panel, now with on-off button
2026-10-05 Checkpoint before ui routing
    [supply_control.kicad_pcb, supply_control_bom.csv, supply_ui.kicad_pcb, supply_ui_bom.csv]
2026-10-05 UI board routed
    [supply_ui.kicad_pcb, supply_ui_bom.csv, supply_ui_dsn.dsn]
